LZajmi/STM32F4-dev-board/README.md

## Project Overview
render
render2
