LZajmi/STM32F4-dev-board/KiCad Libraries/141972109-21-usb4145-03-0170-c/usb4145-03-0170-c.stl

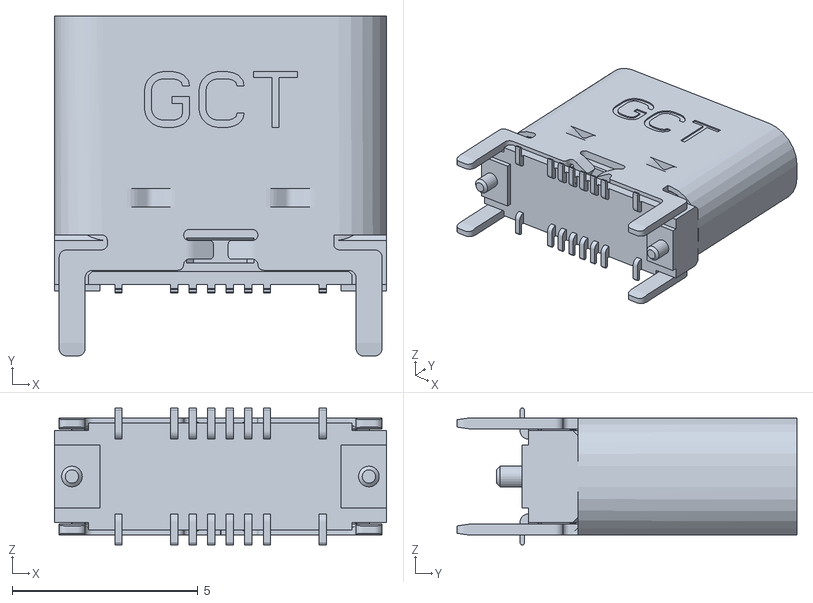
[picture p1: CAD file, 2025-03-24]
KiCad Libraries/141972109-21-usb4145-03-0170-c/usb4145-03-0170-c.stl
8.95 x 9.16 x 3.69
