LZajmi/STM32F4-dev-board/KiCad Libraries/1N4148W-TP/1N4148W-TP.step

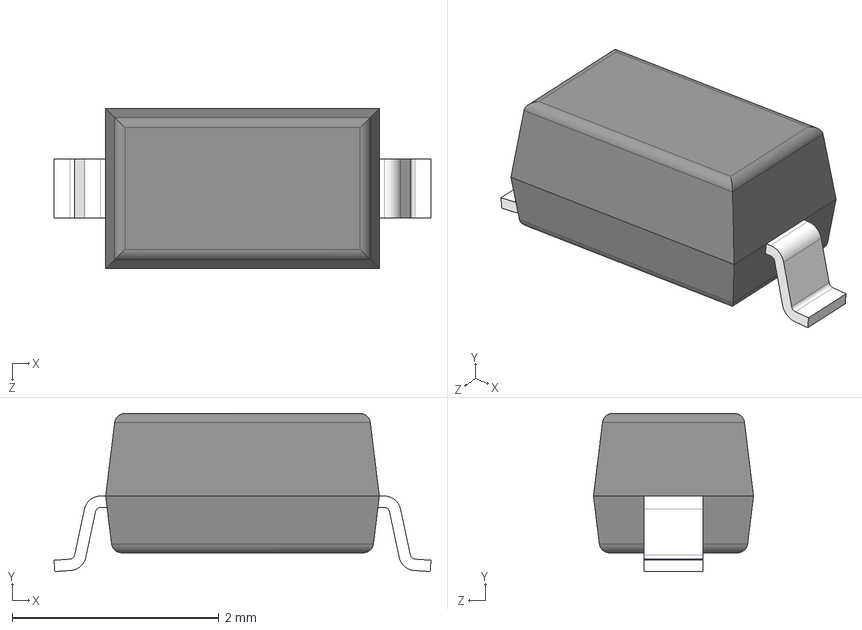
[picture p2: CAD file, 2025-03-24]
KiCad Libraries/1N4148W-TP/1N4148W-TP.step
3.65 x 1.53 x 1.55 mm
