LZajmi/STM32F4-dev-board/KiCad Libraries/3D model/L834-1G1T-S7--3DModel-STEP-56544.STEP

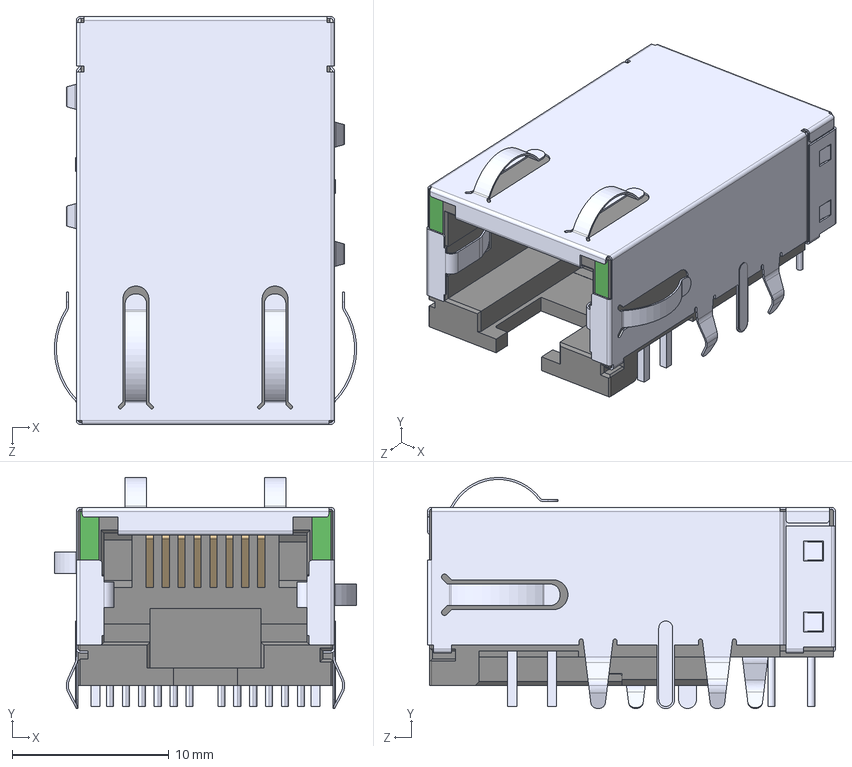
[picture p3: CAD file, 2025-03-24]
KiCad Libraries/3D model/L834-1G1T-S7--3DModel-STEP-56544.STEP
19.3 x 14.8 x 26.1 mm
