LZajmi/STM32F4-dev-board/KiCad Libraries/93C46/93C46.step

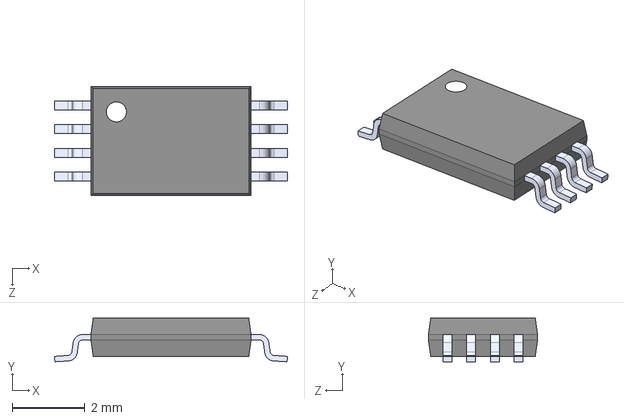
[picture p4: CAD file, 2025-03-24]
KiCad Libraries/93C46/93C46.step
6.40 x 1.20 x 3.00 mm
