LZajmi/STM32F4-dev-board/KiCad Libraries/93C46C-I_P/93C46C-I_P.step

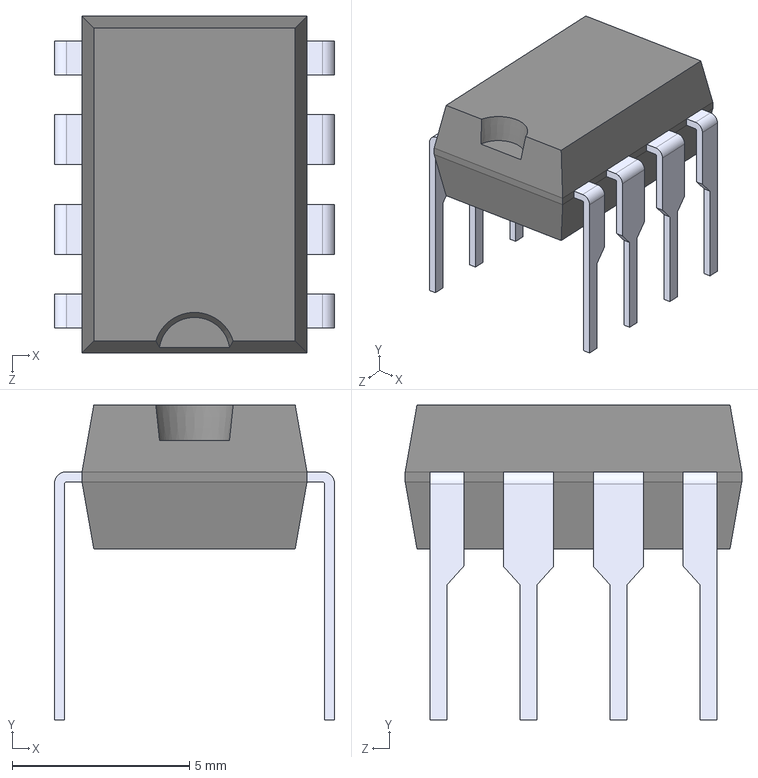
[picture p5: CAD file, 2025-03-24]
KiCad Libraries/93C46C-I_P/93C46C-I_P.step
7.91 x 8.89 x 9.50 mm
