LZajmi/STM32F4-dev-board/KiCad Libraries/ABM8-24.000MHZ-B2-T/ABM8-24.000MHZ-B2-T.step

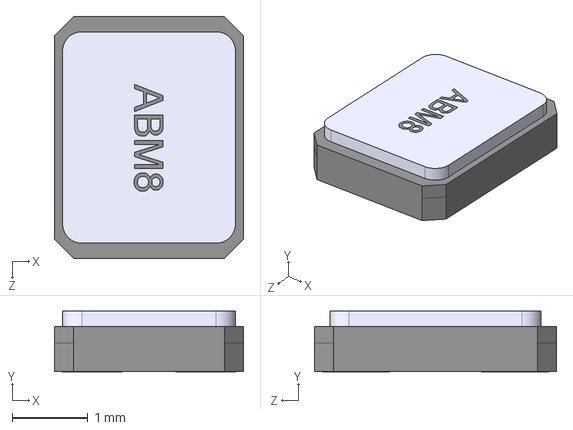
[picture p6: CAD file, 2025-03-24]
KiCad Libraries/ABM8-24.000MHZ-B2-T/ABM8-24.000MHZ-B2-T.step
2.50 x 0.8 x 3.20 mm
