LZajmi/STM32F4-dev-board/KiCad Libraries/ABM8G-12.000MHZ-18-D2Y-T/ABM8G-12.000MHZ-18-D2Y-T.step

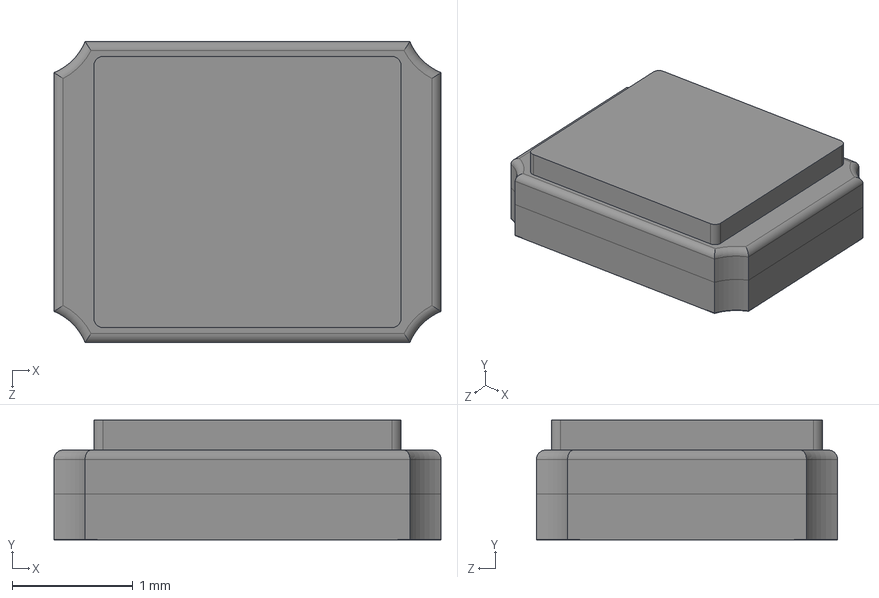
[picture p7: CAD file, 2025-03-24]
KiCad Libraries/ABM8G-12.000MHZ-18-D2Y-T/ABM8G-12.000MHZ-18-D2Y-T.step
3.20 x 0.991 x 2.49 mm
