LZajmi/STM32F4-dev-board/KiCad Libraries/AltiumDesigner-Libraries-main/LQFP48-7x7mm.step

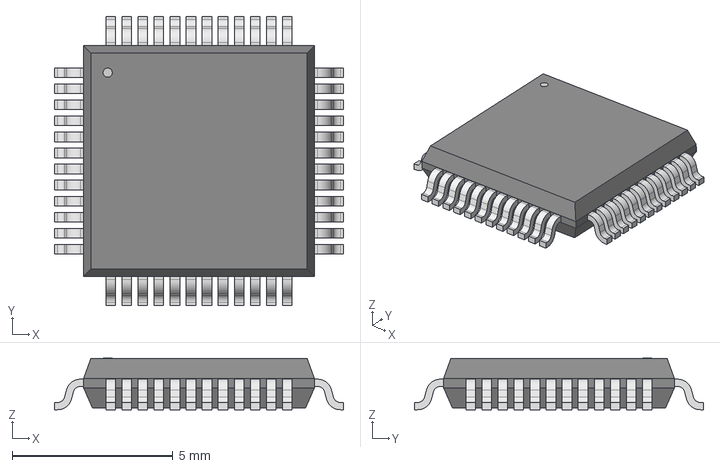
[picture p8: CAD file, 2025-03-24]
KiCad Libraries/AltiumDesigner-Libraries-main/LQFP48-7x7mm.step
8.99 x 8.99 x 1.60 mm
