LZajmi/STM32F4-dev-board/KiCad Libraries/B3AL_1003P/b3al-1003p.stp

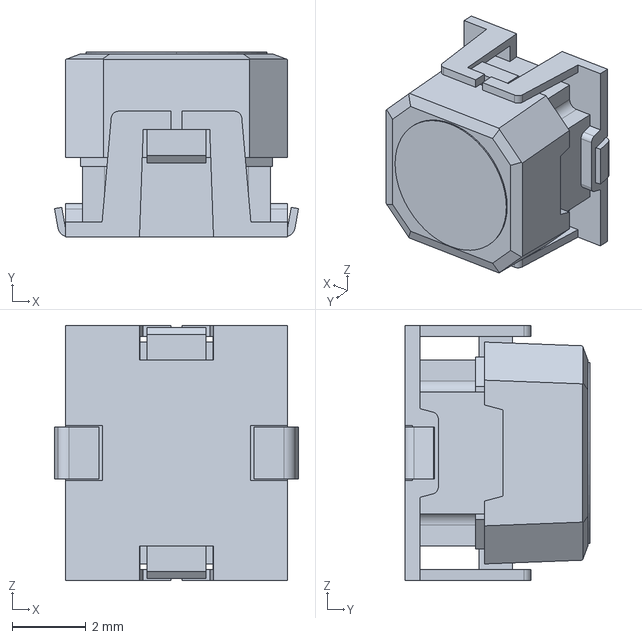
[picture p9: CAD file, 2025-03-24]
KiCad Libraries/B3AL_1003P/b3al-1003p.stp
6.60 x 5.00 x 6.90 mm
