LZajmi/STM32F4-dev-board/KiCad Libraries/BLM15AG601SN1D/BLM15AG601SN1D.step

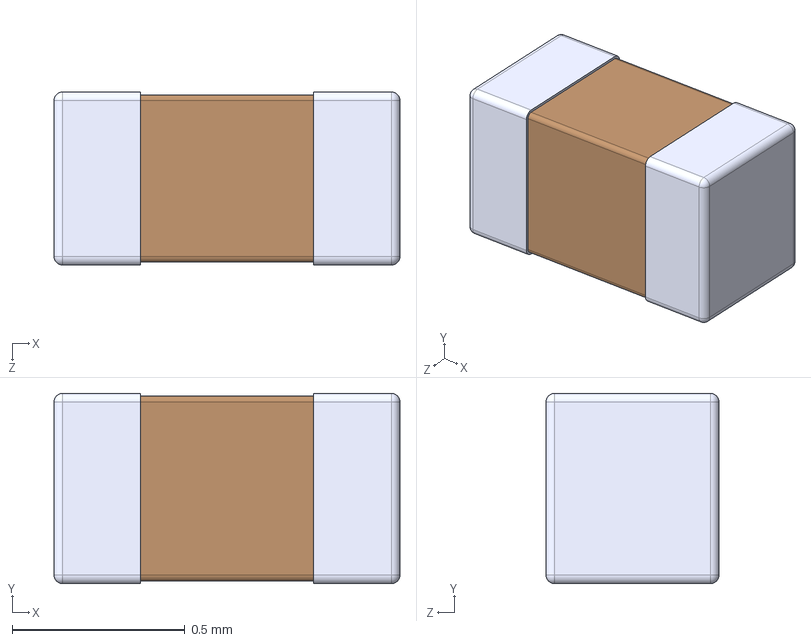
[picture p10: CAD file, 2025-03-24]
KiCad Libraries/BLM15AG601SN1D/BLM15AG601SN1D.step
1.00 x 0.55 x 0.5 mm
