LZajmi/STM32F4-dev-board/KiCad Libraries/BMI270/BMI270.step

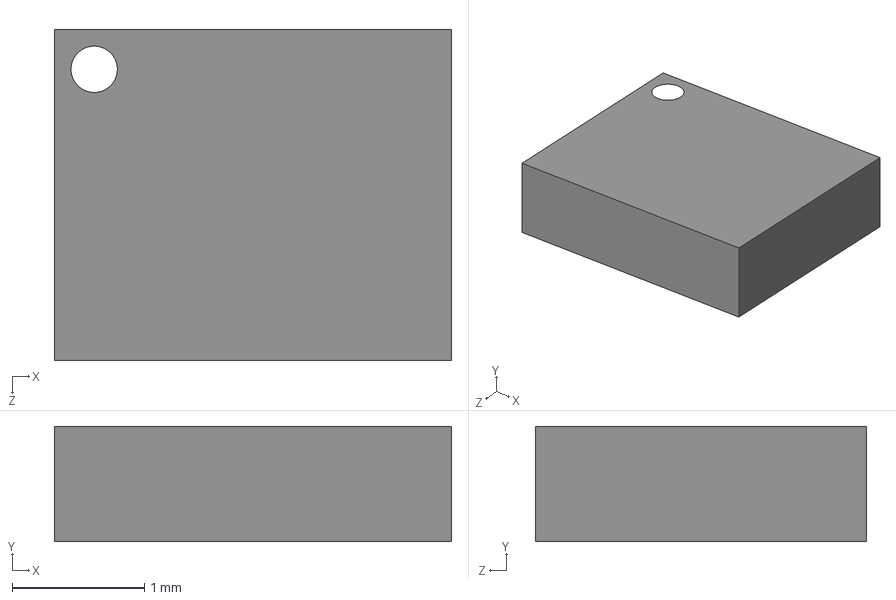
[picture p11: CAD file, 2025-03-24]
KiCad Libraries/BMI270/BMI270.step
3.00 x 0.87 x 2.50 mm
