LZajmi/STM32F4-dev-board/KiCad Libraries/CC0201MRX5R6BB105/AltiumDesigner/CAP_CC0201_YAG.step

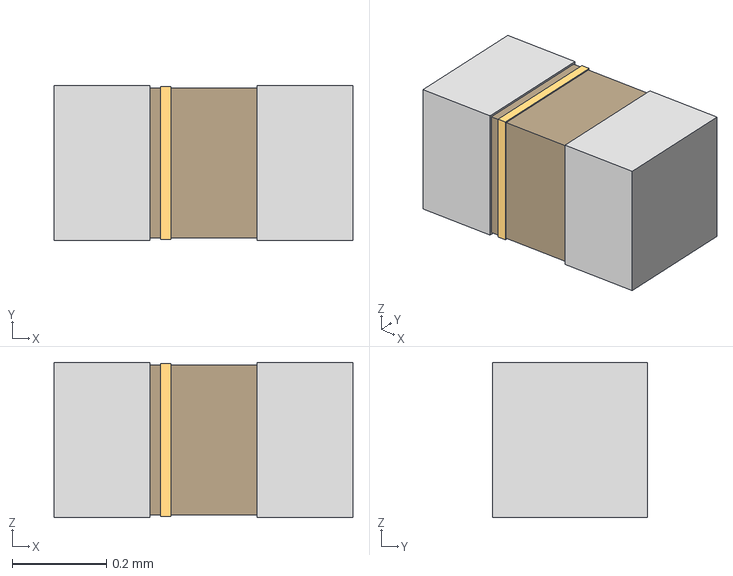
[picture p12: CAD file, 2025-03-24]
KiCad Libraries/CC0201MRX5R6BB105/AltiumDesigner/CAP_CC0201_YAG.step
0.636 x 0.33 x 0.33 mm
