LZajmi/STM32F4-dev-board/KiCad Libraries/CC0402MRX5R6BB106/AltiumDesigner/CAP_CC0402_YAG.step

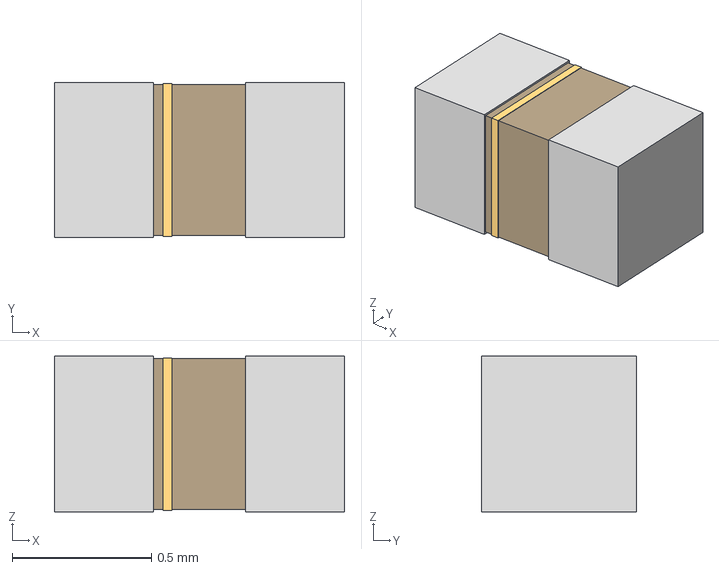
[picture p13: CAD file, 2025-03-24]
KiCad Libraries/CC0402MRX5R6BB106/AltiumDesigner/CAP_CC0402_YAG.step
1.04 x 0.558 x 0.559 mm
