LZajmi/STM32F4-dev-board/KiCad Libraries/CR0402-FX-1002GLF/CR0402-FX-1002GLF.step

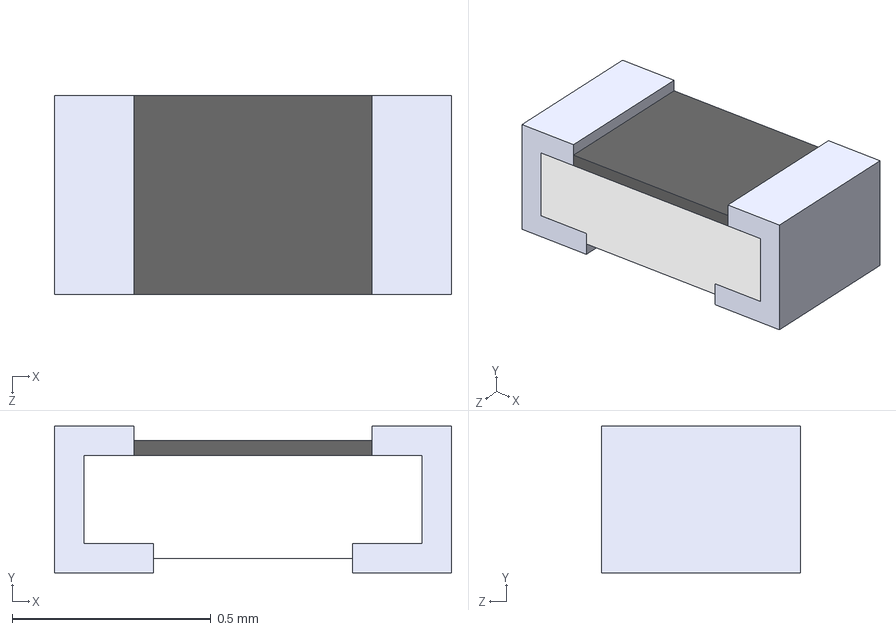
[picture p14: CAD file, 2025-03-24]
KiCad Libraries/CR0402-FX-1002GLF/CR0402-FX-1002GLF.step
1.00 x 0.37 x 0.5 mm
