LZajmi/STM32F4-dev-board/KiCad Libraries/CRCW0402220RFKEDC/CRCW0402220RFKEDC/3D/CRCW0402220RFKEDC.stp

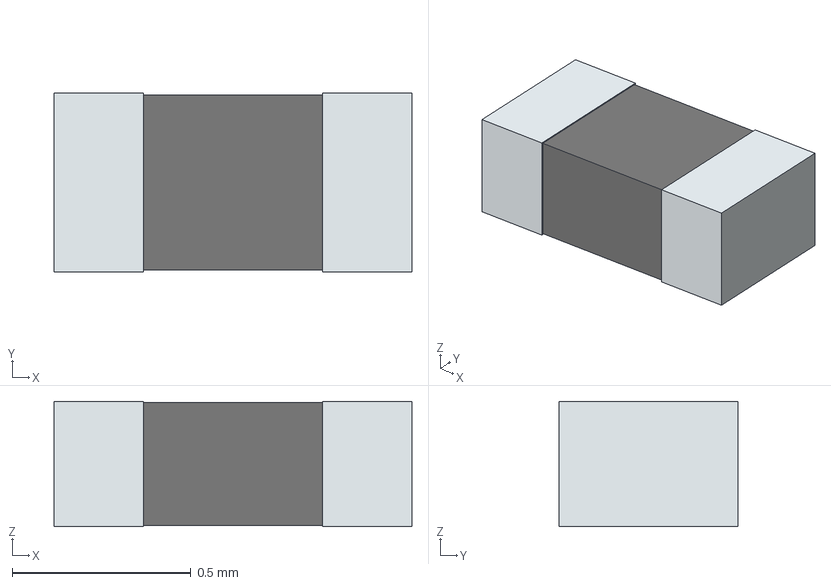
[picture p15: CAD file, 2025-03-24]
KiCad Libraries/CRCW0402220RFKEDC/CRCW0402220RFKEDC/3D/CRCW0402220RFKEDC.stp
1.00 x 0.5 x 0.35 mm
term1
term2
