LZajmi/STM32F4-dev-board/KiCad Libraries/CRCW040266K5FKEDC/CRCW040266K5FKEDC.step

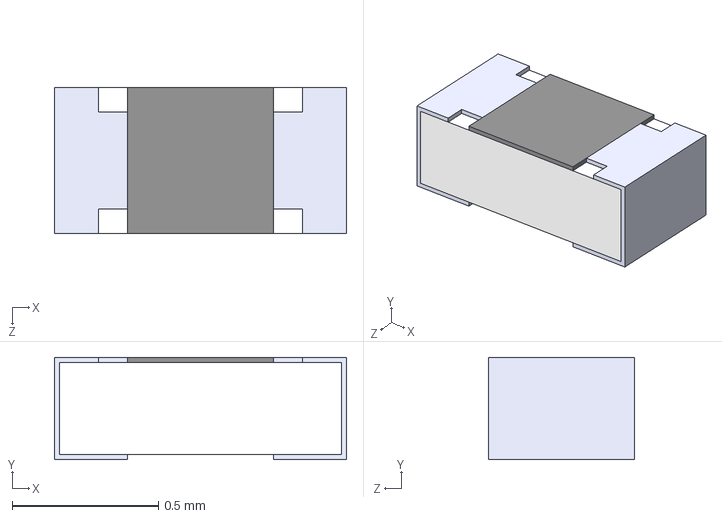
[picture p16: CAD file, 2025-03-24]
KiCad Libraries/CRCW040266K5FKEDC/CRCW040266K5FKEDC.step
1 x 0.35 x 0.5 mm
