LZajmi/STM32F4-dev-board/KiCad Libraries/DC-005/DC-005.step

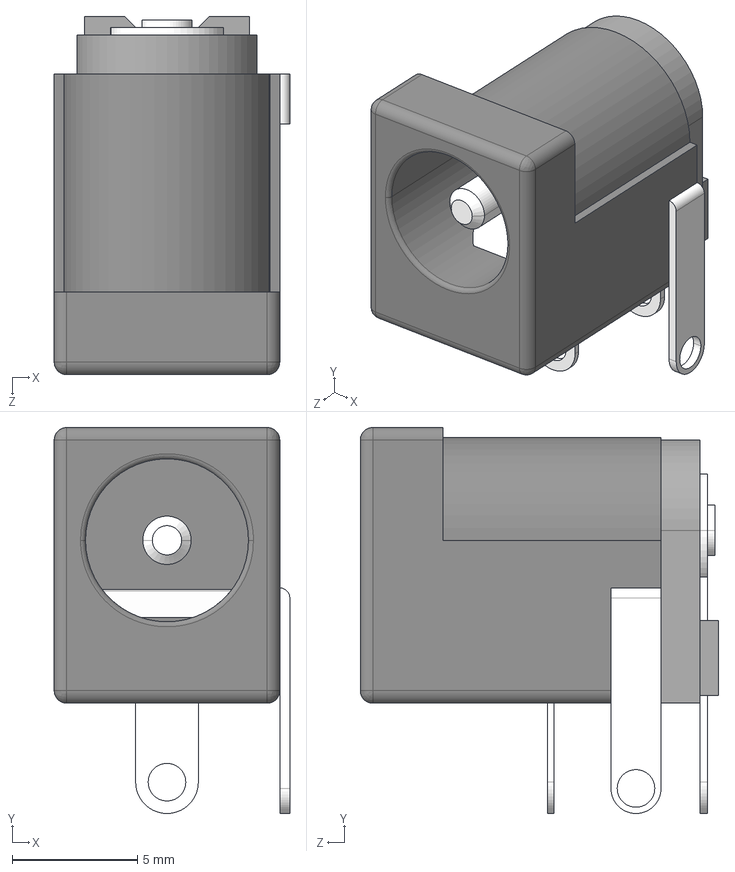
[picture p17: CAD file, 2025-03-24]
KiCad Libraries/DC-005/DC-005.step
9.40 x 15.4 x 14.3 mm
