LZajmi/STM32F4-dev-board/KiCad Libraries/DCJ200-10-A-XX-K_REVA/DCJ200-10-A-XX-K_REVA.step

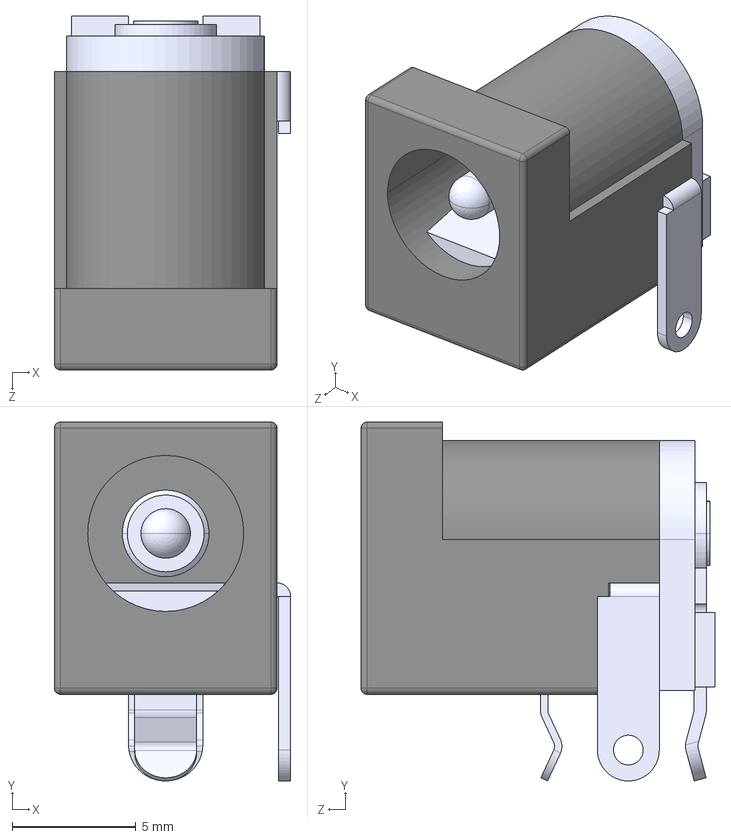
[picture p18: CAD file, 2025-03-24]
KiCad Libraries/DCJ200-10-A-XX-K_REVA/DCJ200-10-A-XX-K_REVA.step
9.55 x 14.5 x 14.3 mm
