LZajmi/STM32F4-dev-board/KiCad Libraries/ECS-2520MV-130-BN-TR/ECS-2520MV-130-BN-TR/3D/ECS-2520MV-130-BN-TR.stp

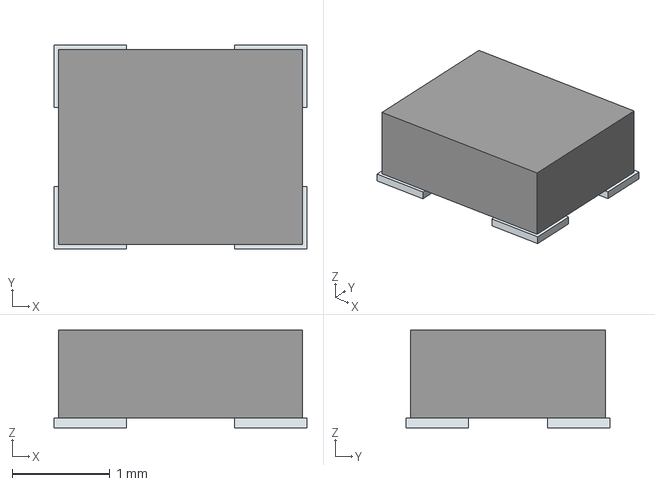
[picture p19: CAD file, 2025-03-24]
KiCad Libraries/ECS-2520MV-130-BN-TR/ECS-2520MV-130-BN-TR/3D/ECS-2520MV-130-BN-TR.stp
2.59 x 2.09 x 1.00 mm
Pins
