LZajmi/STM32F4-dev-board/KiCad Libraries/ECS-2520MV-480-BN-TR/ECS-2520MV-480-BN-TR.step

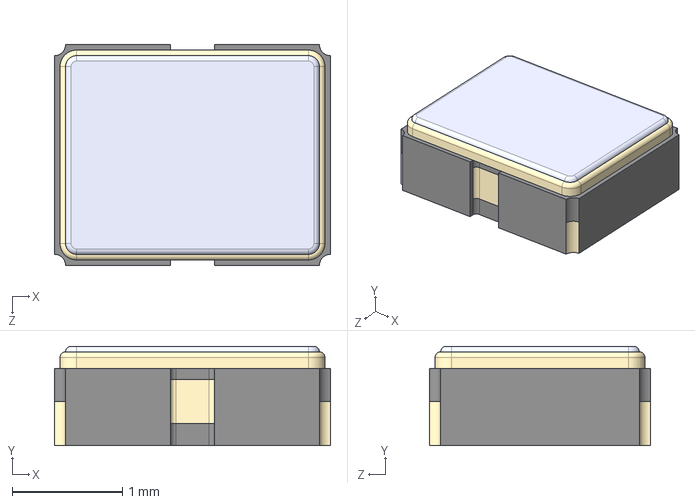
[picture p20: CAD file, 2025-03-24]
KiCad Libraries/ECS-2520MV-480-BN-TR/ECS-2520MV-480-BN-TR.step
2.50 x 0.9 x 2.00 mm
