LZajmi/STM32F4-dev-board/KiCad Libraries/ERJ3EKF4533V/ERJ3EKF4533V.step

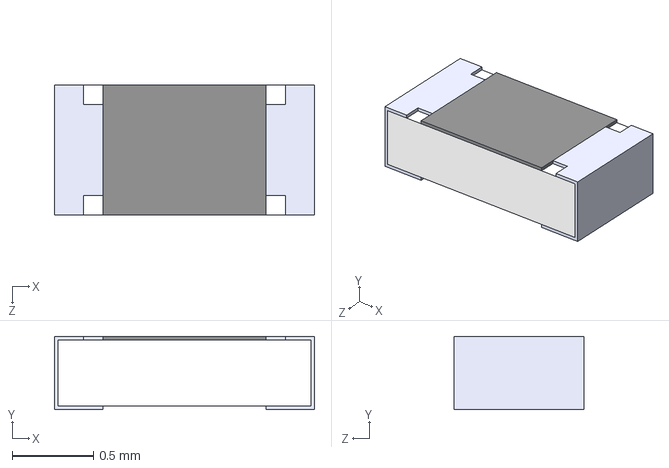
[picture p21: CAD file, 2025-03-24]
KiCad Libraries/ERJ3EKF4533V/ERJ3EKF4533V.step
1.60 x 0.45 x 0.8 mm
