LZajmi/STM32F4-dev-board/KiCad Libraries/FT4232H_56Q_TRAY/FT4232H-56Q-TRAY.step

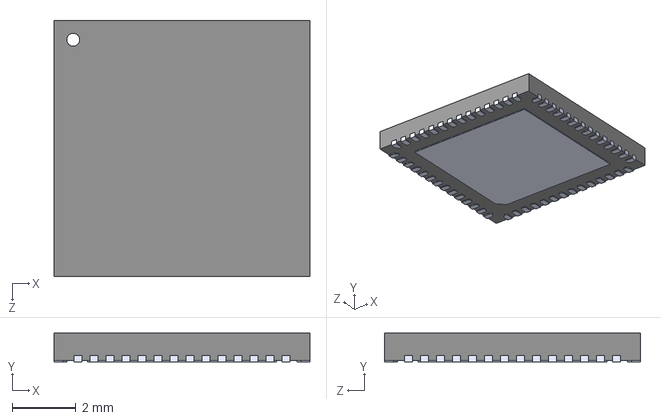
[picture p22: CAD file, 2025-03-24]
KiCad Libraries/FT4232H_56Q_TRAY/FT4232H-56Q-TRAY.step
8.00 x 0.9 x 8.00 mm
