LZajmi/STM32F4-dev-board/KiCad Libraries/FW-10-04-G-D-100-065/FW-10-04-G-D-100-065.step

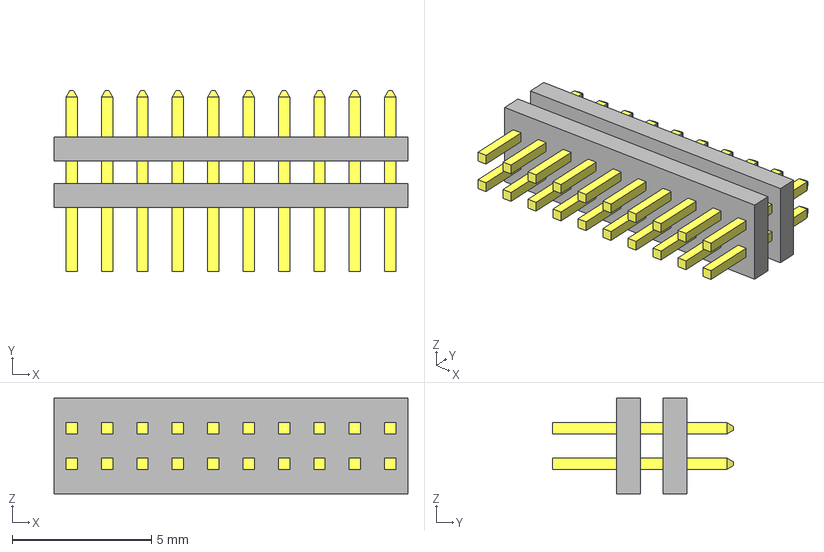
[picture p23: CAD file, 2025-03-24]
KiCad Libraries/FW-10-04-G-D-100-065/FW-10-04-G-D-100-065.step
12.7 x 6.48 x 3.43 mm
FW-10-04-G-D-100-065_bottom_body
FW-10-04-G-D-100-065_pins1
FW-10-04-G-D-100-100_pins2
FW-10-04-G-D-100-065_top_body
