LZajmi/STM32F4-dev-board/KiCad Libraries/GRM21BR71A475KE51L/GRM21BR71A475KE51L.step

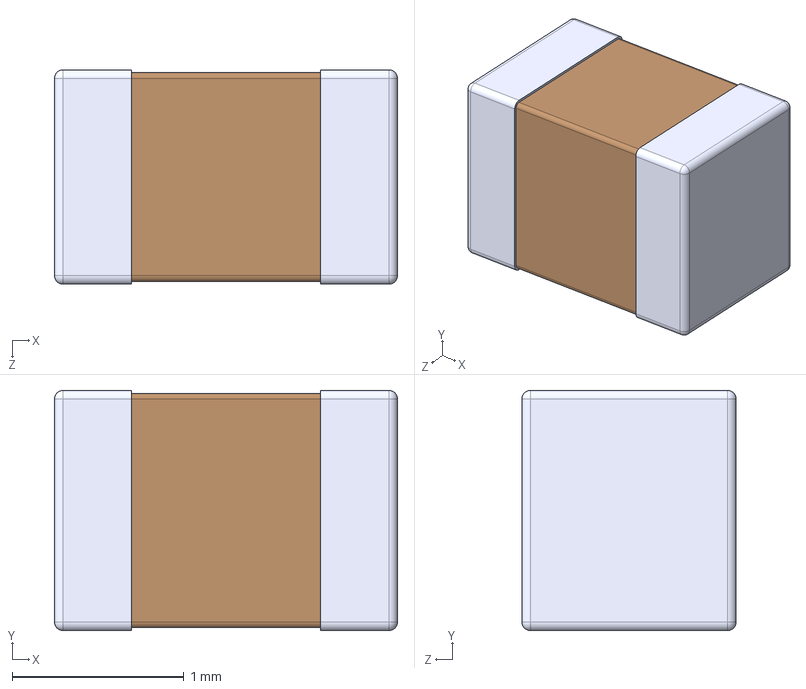
[picture p24: CAD file, 2025-03-24]
KiCad Libraries/GRM21BR71A475KE51L/GRM21BR71A475KE51L.step
2.00 x 1.40 x 1.25 mm
