LZajmi/STM32F4-dev-board/KiCad Libraries/HSMW_C191/HSMW-C191.step

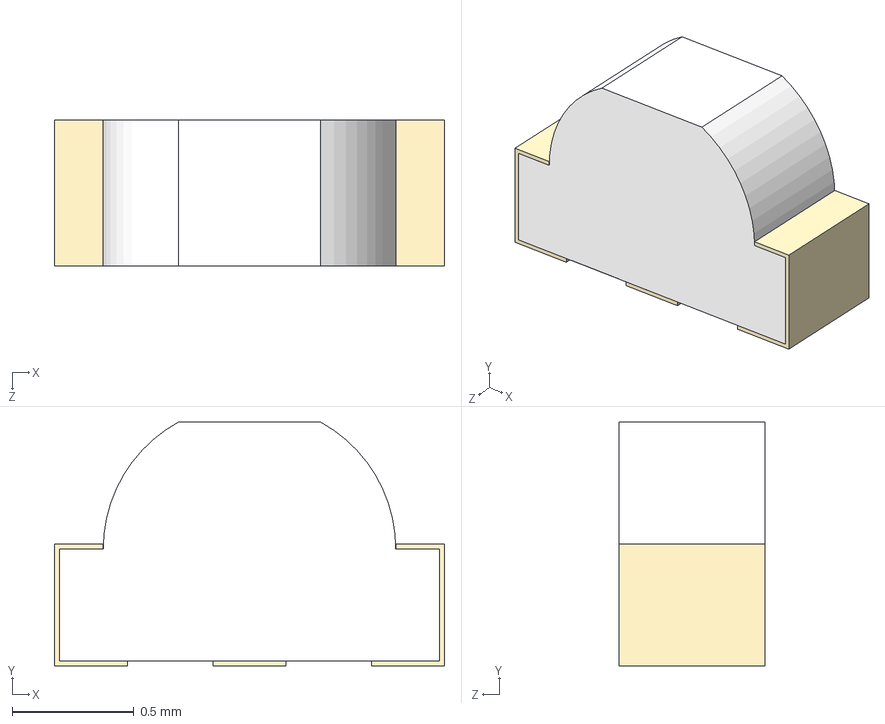
[picture p25: CAD file, 2025-03-24]
KiCad Libraries/HSMW_C191/HSMW-C191.step
1.60 x 1.00 x 0.6 mm
