LZajmi/STM32F4-dev-board/KiCad Libraries/KSZ9031RNXCA/KSZ9031RNXCA.step

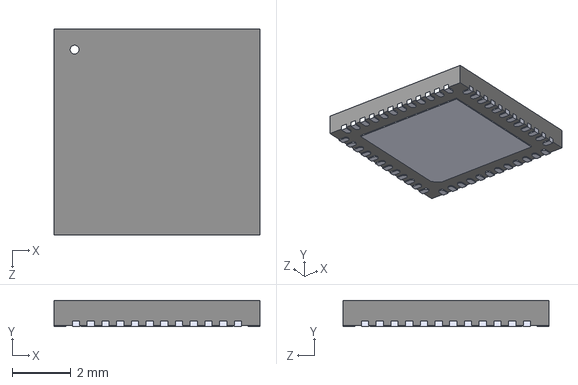
[picture p26: CAD file, 2025-03-24]
KiCad Libraries/KSZ9031RNXCA/KSZ9031RNXCA.step
7.00 x 0.9 x 7.00 mm
