LZajmi/STM32F4-dev-board/KiCad Libraries/LIB_MT25QL512ABB8ESF-0AAT/MT25QL512ABB8ESF-0AAT/3D/MT25QL512ABB8ESF-0AAT.stp

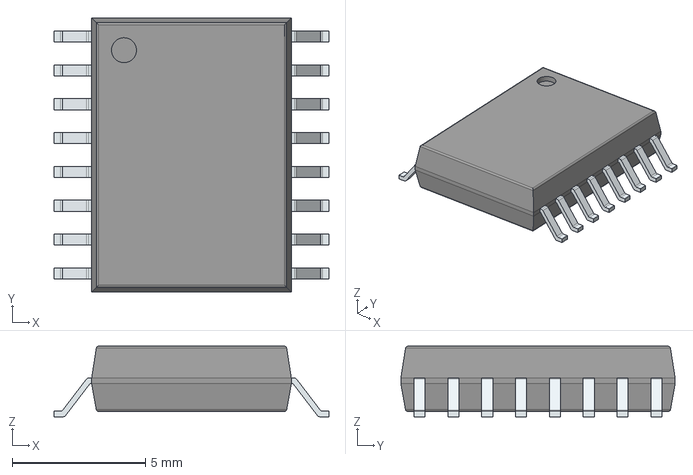
[picture p27: CAD file, 2025-03-24]
KiCad Libraries/LIB_MT25QL512ABB8ESF-0AAT/MT25QL512ABB8ESF-0AAT/3D/MT25QL512ABB8ESF-0AAT.stp
10.3 x 10.3 x 2.65 mm
PinsArrayLR
