LZajmi/STM32F4-dev-board/KiCad Libraries/LIB_PCM12SMTR/PCM12SMTR/3D/PCM12SMTR.stp

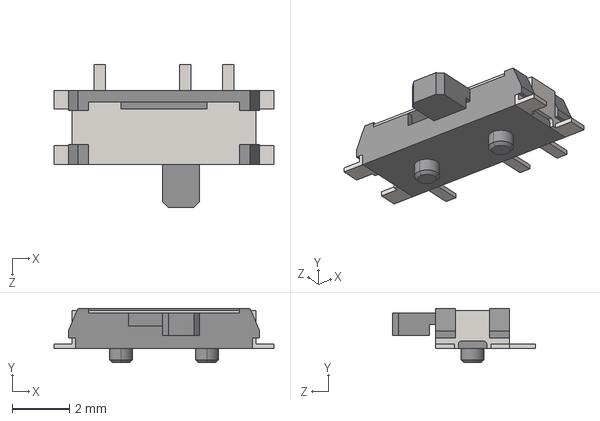
[picture p28: CAD file, 2025-03-24]
KiCad Libraries/LIB_PCM12SMTR/PCM12SMTR/3D/PCM12SMTR.stp
7.70 x 1.90 x 5.00 mm
