LZajmi/STM32F4-dev-board/KiCad Libraries/LIB_RN73R1ETTP50R0F50/RN73R1ETTP50R0F50/3D/RN73R1ETTP50R0F50.stp

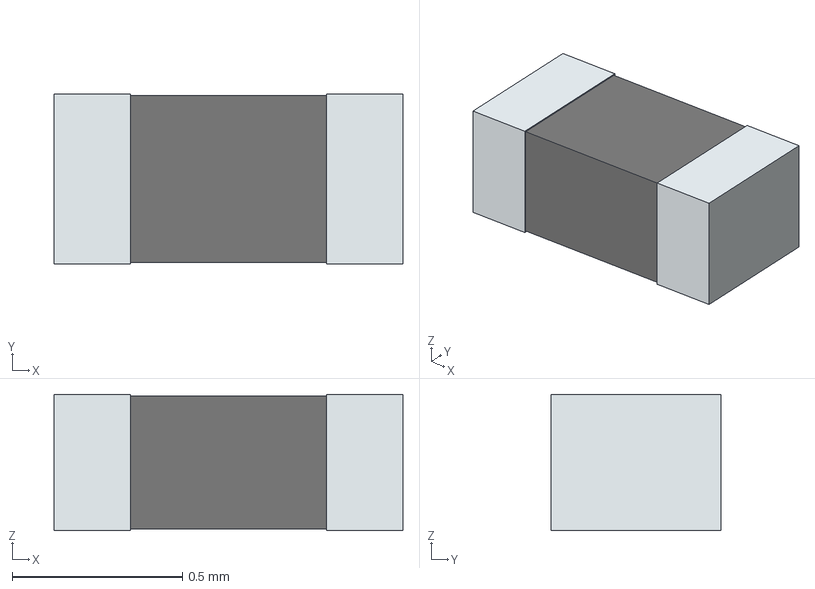
[picture p29: CAD file, 2025-03-24]
KiCad Libraries/LIB_RN73R1ETTP50R0F50/RN73R1ETTP50R0F50/3D/RN73R1ETTP50R0F50.stp
1.02 x 0.5 x 0.4 mm
term1
term2
