LZajmi/STM32F4-dev-board/KiCad Libraries/LIB_SN74LV1T125DCKRG4/SN74LV1T125DCKRG4/3D/SN74LV1T125DCKRG4.stp

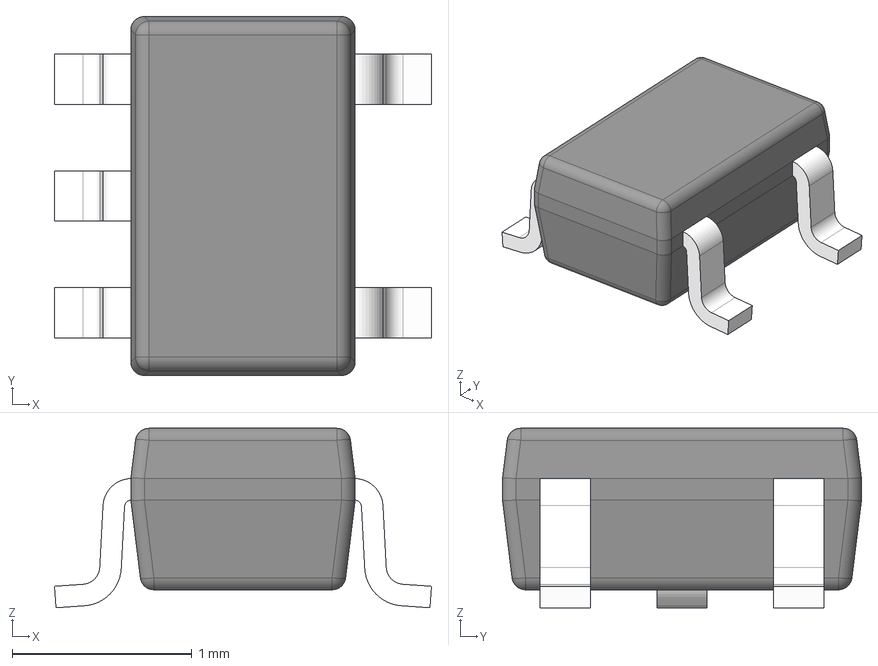
[picture p30: CAD file, 2025-03-24]
KiCad Libraries/LIB_SN74LV1T125DCKRG4/SN74LV1T125DCKRG4/3D/SN74LV1T125DCKRG4.stp
2.10 x 2.00 x 1.00 mm
BODY-SOT
LEAD-SOT x 5
PIN1-ID
