LZajmi/STM32F4-dev-board/KiCad Libraries/LIB_TPD2E009DBZR/TPD2E009DBZR/3D/TPD2E009DBZR.stp

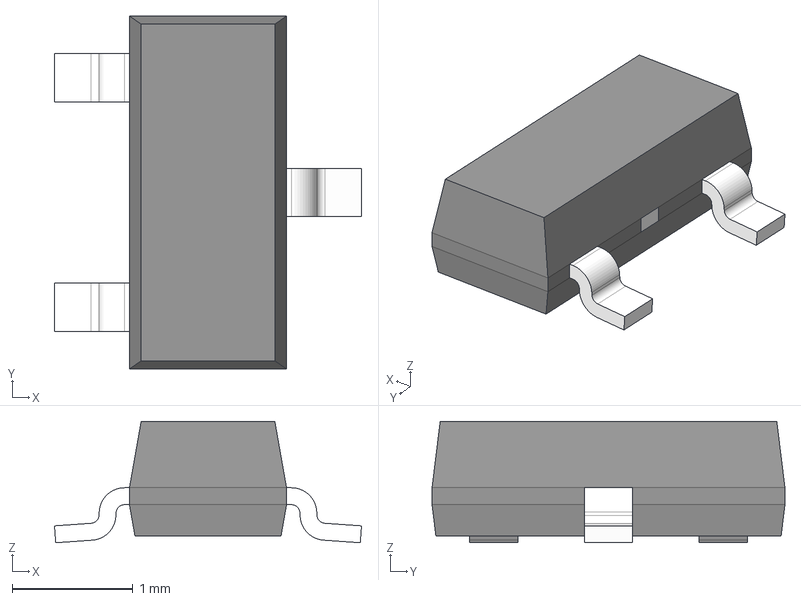
[picture p31: CAD file, 2025-03-24]
KiCad Libraries/LIB_TPD2E009DBZR/TPD2E009DBZR/3D/TPD2E009DBZR.stp
2.54 x 2.92 x 1.01 mm
BODY-SOT
LEAD-SOT x 3
PIN1-ID
TIEBAR
