LZajmi/STM32F4-dev-board/KiCad Libraries/LIB_XFL4015-471MEC/XFL4015-471MEC/3D/XFL4015-471MEC.stp

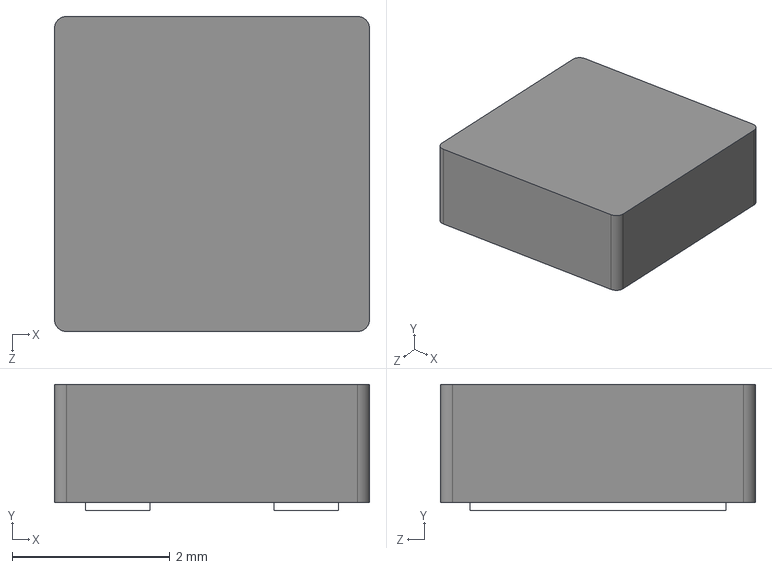
[picture p32: CAD file, 2025-03-24]
KiCad Libraries/LIB_XFL4015-471MEC/XFL4015-471MEC/3D/XFL4015-471MEC.stp
4.00 x 1.60 x 4.00 mm
