LZajmi/STM32F4-dev-board/KiCad Libraries/LIS3DH/LIS3DH.step

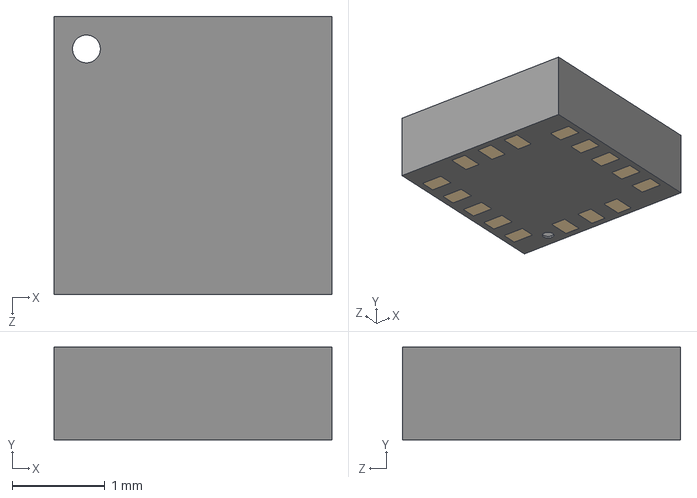
[picture p33: CAD file, 2025-03-24]
KiCad Libraries/LIS3DH/LIS3DH.step
3.00 x 1.00 x 3.00 mm
