LZajmi/STM32F4-dev-board/KiCad Libraries/MPU-6050/MPU-6050.step

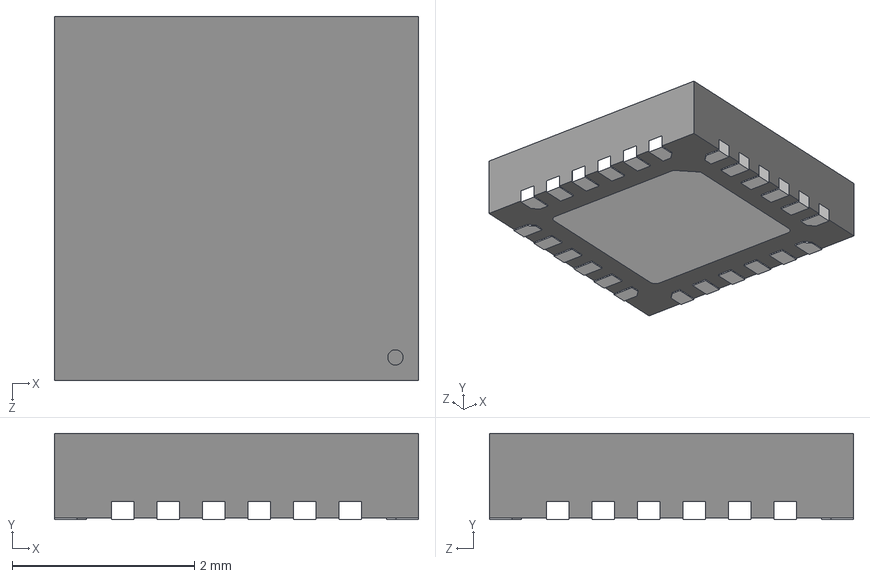
[picture p34: CAD file, 2025-03-24]
KiCad Libraries/MPU-6050/MPU-6050.step
4.00 x 0.95 x 4.00 mm
