LZajmi/STM32F4-dev-board/KiCad Libraries/MT25QL512ABB8ESF-0AAT/MT25QL512ABB8ESF-0AAT.step

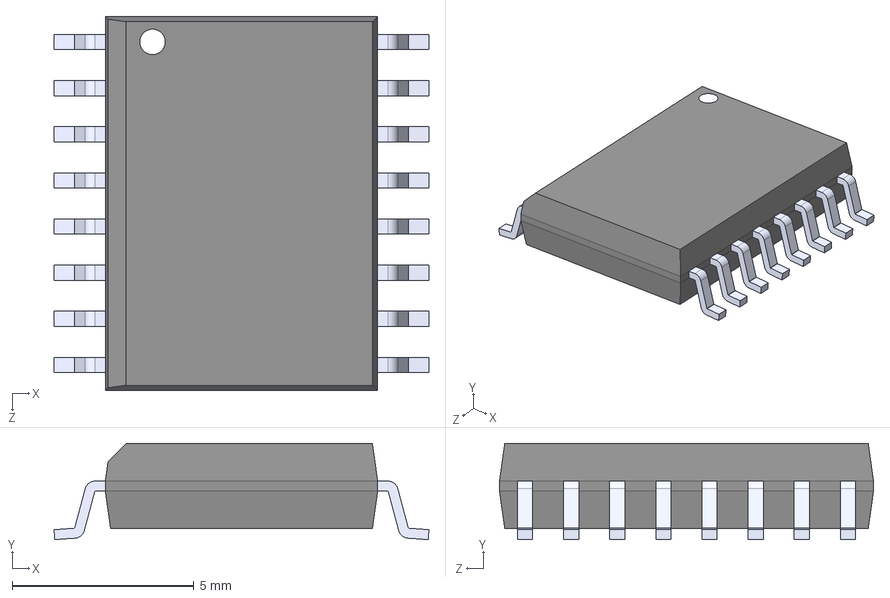
[picture p35: CAD file, 2025-03-24]
KiCad Libraries/MT25QL512ABB8ESF-0AAT/MT25QL512ABB8ESF-0AAT.step
10.3 x 2.65 x 10.3 mm
