LZajmi/STM32F4-dev-board/KiCad Libraries/PARTserver22024110721085440054269d0b6156e/TSW-120-24-T-S.stp

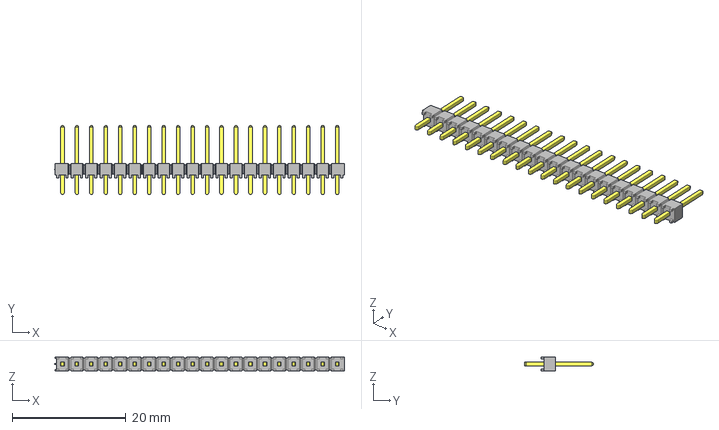
[picture p36: CAD file, 2025-03-24]
KiCad Libraries/PARTserver22024110721085440054269d0b6156e/TSW-120-24-T-S.stp
50.9 x 12.2 x 2.54 mm
TSW-120-24-T-S_body
T-1S6-17-TSW-1-24-20-S
