LZajmi/STM32F4-dev-board/KiCad Libraries/RC0402FR-07100RL/RC0402FR-07100RL.step

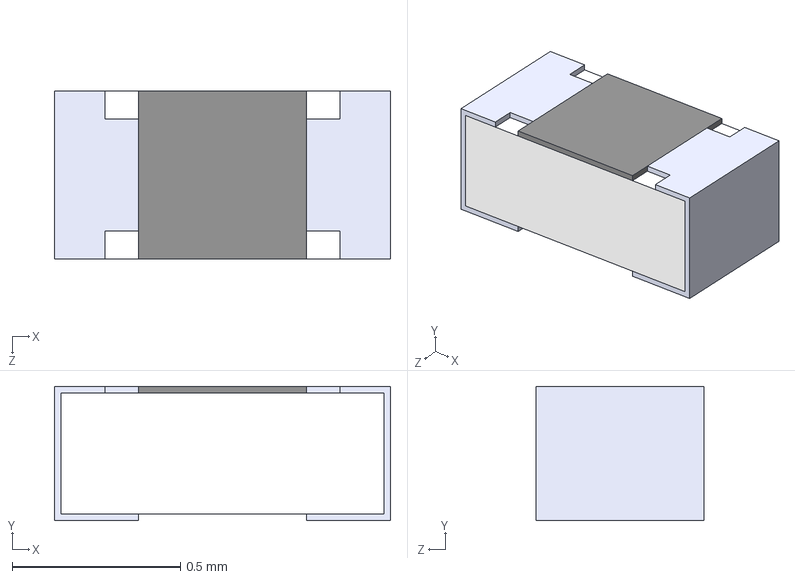
[picture p37: CAD file, 2025-03-24]
KiCad Libraries/RC0402FR-07100RL/RC0402FR-07100RL.step
1 x 0.4 x 0.5 mm
