LZajmi/STM32F4-dev-board/KiCad Libraries/RC0603FR-07100KL/RC0603FR-07100KL.step

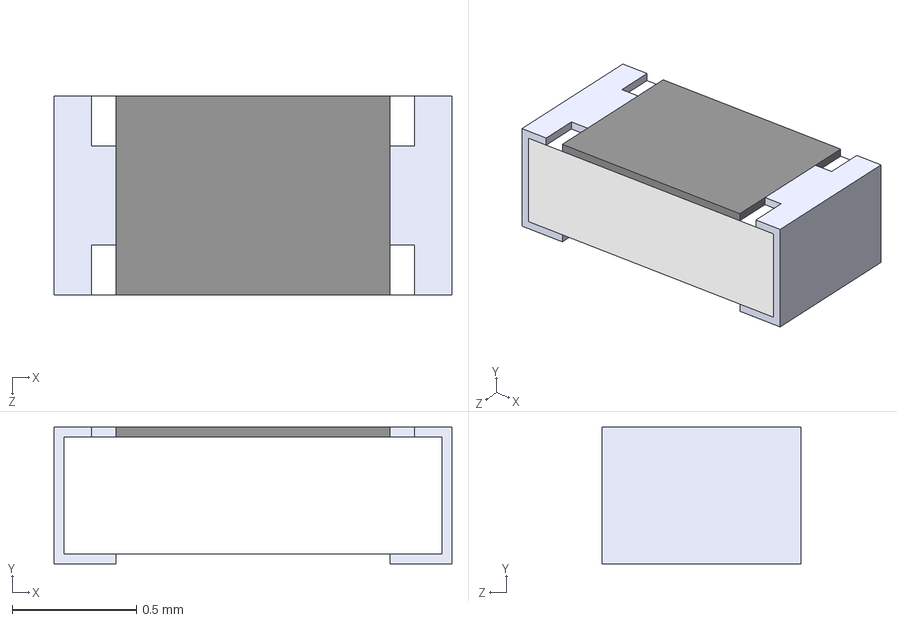
[picture p38: CAD file, 2025-03-24]
KiCad Libraries/RC0603FR-07100KL/RC0603FR-07100KL.step
1.60 x 0.55 x 0.8 mm
