LZajmi/STM32F4-dev-board/KiCad Libraries/RC0603FR-0710K2L/RC0603FR-0710K2L.step

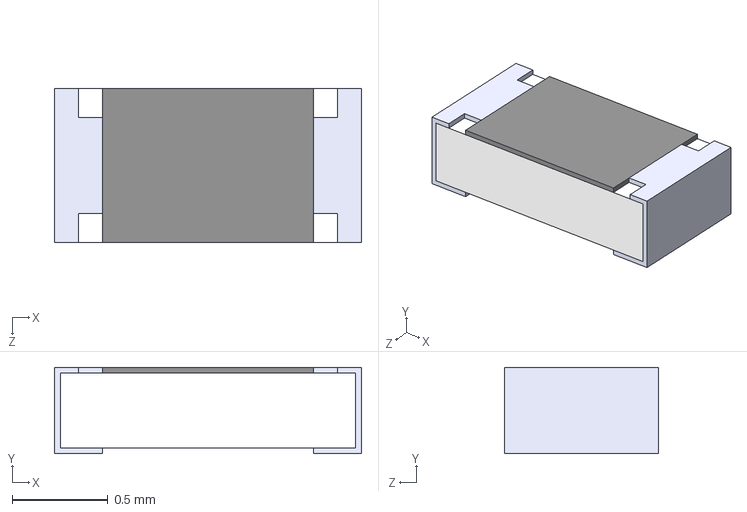
[picture p39: CAD file, 2025-03-24]
KiCad Libraries/RC0603FR-0710K2L/RC0603FR-0710K2L.step
1.60 x 0.45 x 0.8 mm
