LZajmi/STM32F4-dev-board/KiCad Libraries/RMCF0402FT27K0/RMCF0402FT27K0.step

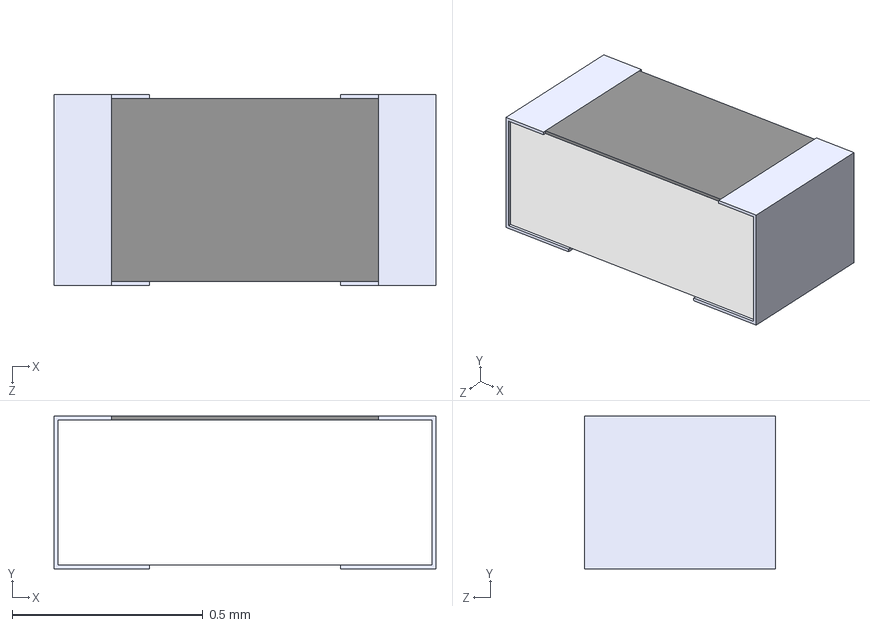
[picture p40: CAD file, 2025-03-24]
KiCad Libraries/RMCF0402FT27K0/RMCF0402FT27K0.step
1.00 x 0.4 x 0.5 mm
