LZajmi/STM32F4-dev-board/KiCad Libraries/SP3003_02XTG/AltiumDesigner/SOT553_LTF.step

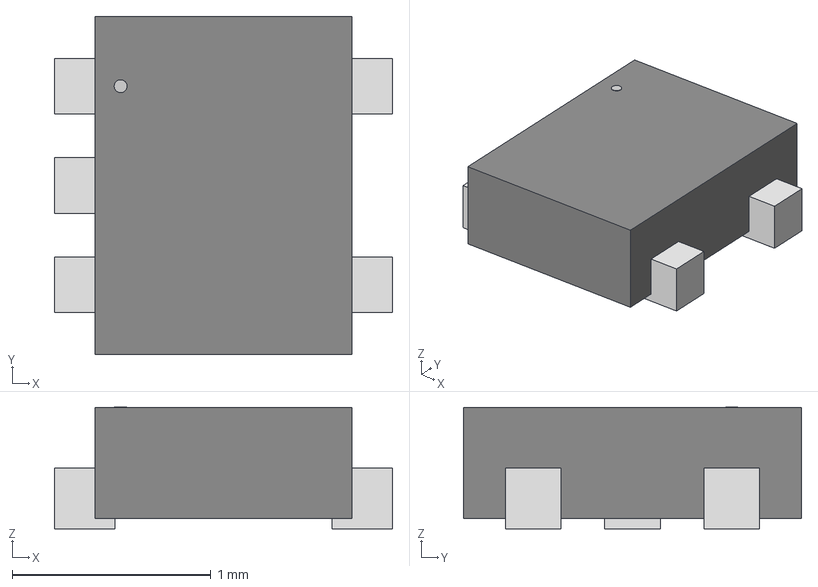
[picture p41: CAD file, 2025-03-24]
KiCad Libraries/SP3003_02XTG/AltiumDesigner/SOT553_LTF.step
1.70 x 1.70 x 0.612 mm
