LZajmi/STM32F4-dev-board/KiCad Libraries/SPM6530T-100M-HZ/SPM6530T-100M-HZ.step

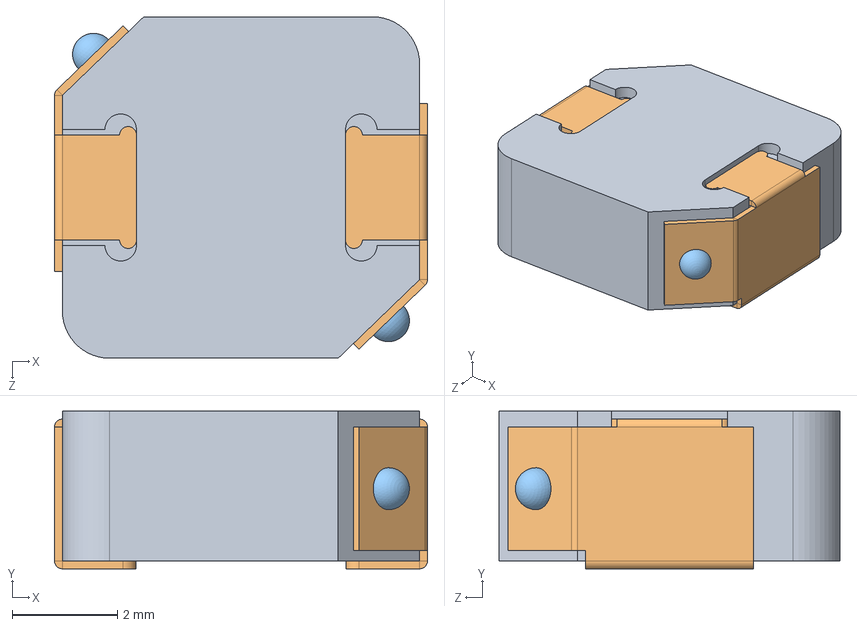
[picture p42: CAD file, 2025-03-24]
KiCad Libraries/SPM6530T-100M-HZ/SPM6530T-100M-HZ.step
7.10 x 3.00 x 6.50 mm
