LZajmi/STM32F4-dev-board/KiCad Libraries/STM32H750Vb/STM32H750VBT6.STEP

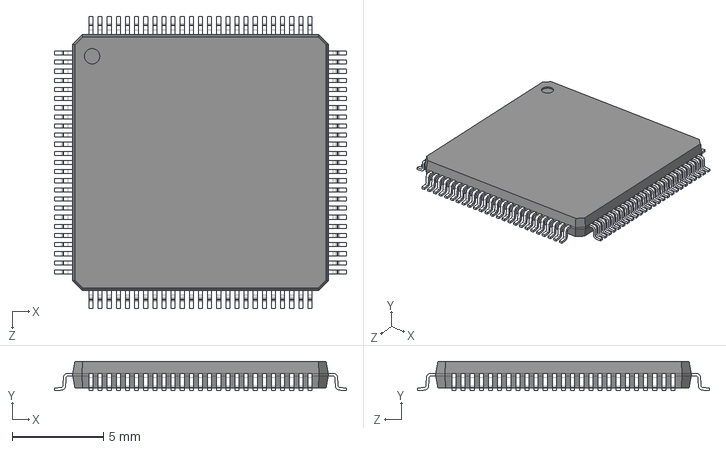
[picture p43: CAD file, 2025-03-24]
KiCad Libraries/STM32H750Vb/STM32H750VBT6.STEP
16.0 x 1.60 x 16.0 mm
