LZajmi/STM32F4-dev-board/KiCad Libraries/TPD2E009DRTR/TPD2E009DRTR.step

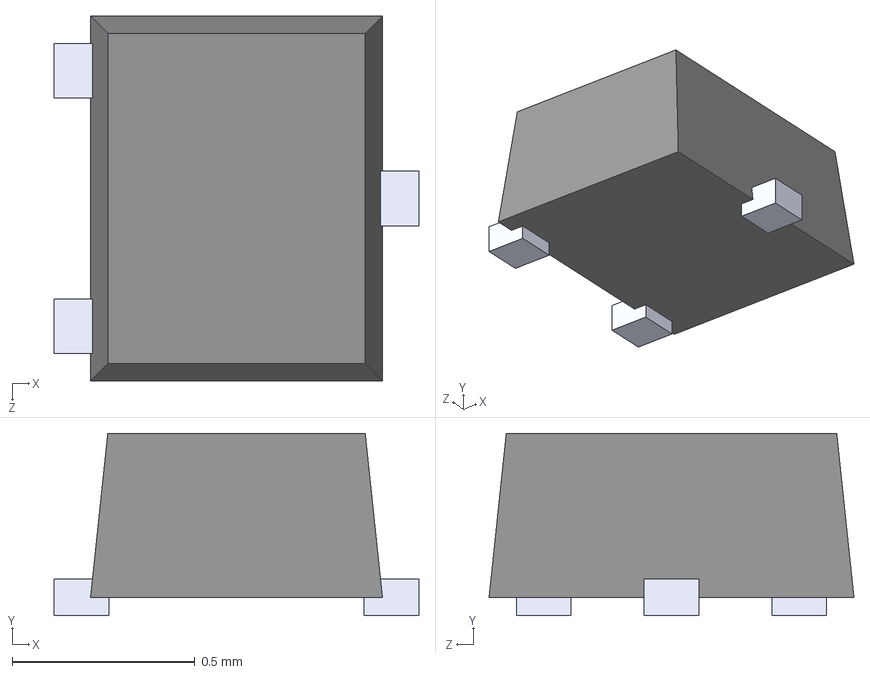
[picture p44: CAD file, 2025-03-24]
KiCad Libraries/TPD2E009DRTR/TPD2E009DRTR.step
1.00 x 0.5 x 1.00 mm
