LZajmi/STM32F4-dev-board/KiCad Libraries/TPD4E05U06DQAR/TPD4E05U06DQAR.step

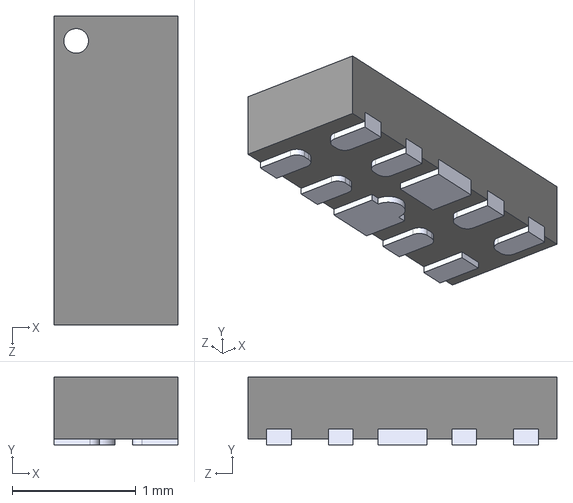
[picture p45: CAD file, 2025-03-24]
KiCad Libraries/TPD4E05U06DQAR/TPD4E05U06DQAR.step
1.00 x 0.55 x 2.50 mm
