LZajmi/STM32F4-dev-board/KiCad Libraries/TSX-3225/TSX-3225.step

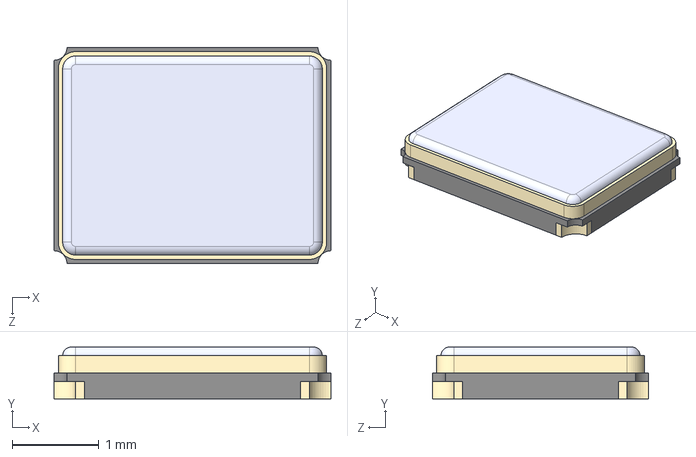
[picture p46: CAD file, 2025-03-24]
KiCad Libraries/TSX-3225/TSX-3225.step
3.20 x 0.6 x 2.50 mm
