LZajmi/STM32F4-dev-board/KiCad Libraries/USB3300-EZK-TR/USB3300-EZK-TR.step

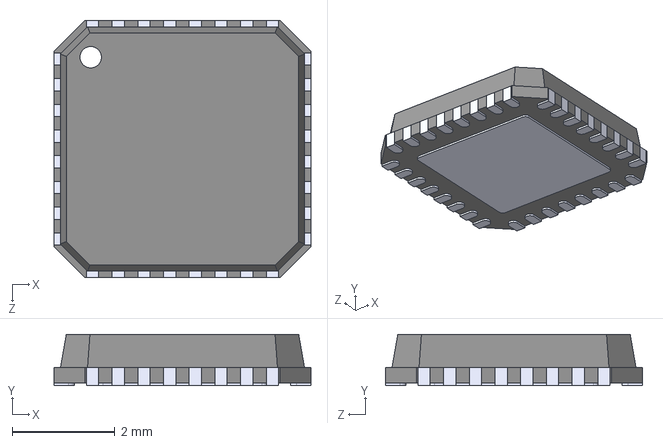
[picture p47: CAD file, 2025-03-24]
KiCad Libraries/USB3300-EZK-TR/USB3300-EZK-TR.step
5.00 x 1.00 x 5.00 mm
