LZajmi/STM32F4-dev-board/KiCad Libraries/USB4145-03-0070-C_REVA2/USB4145-03-0070-C_REVA2.step

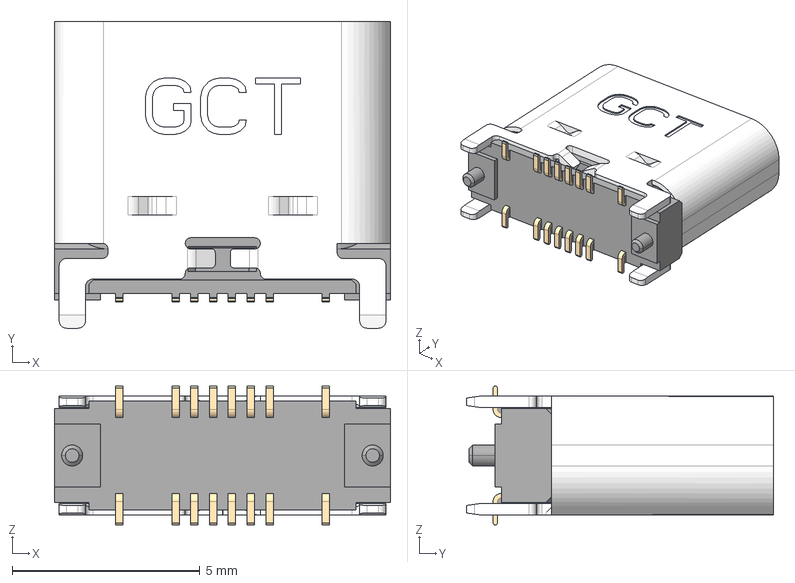
[picture p48: CAD file, 2025-03-24]
KiCad Libraries/USB4145-03-0070-C_REVA2/USB4145-03-0070-C_REVA2.step
8.95 x 8.16 x 3.69 mm
