LZajmi/STM32F4-dev-board/KiCad Libraries/W25Q32JVSSIQ/W25Q32JVSSIQ.step

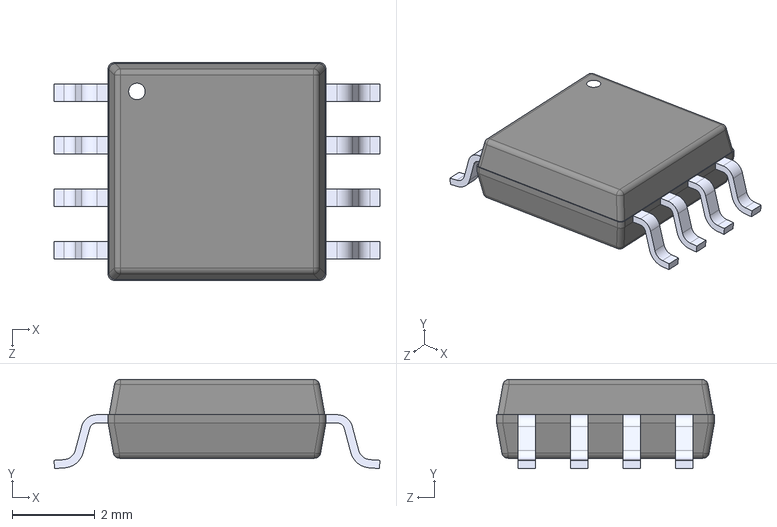
[picture p49: CAD file, 2025-03-24]
KiCad Libraries/W25Q32JVSSIQ/W25Q32JVSSIQ.step
7.90 x 2.16 x 5.28 mm
