LZajmi/STM32F4-dev-board/KiCad Libraries/XC7A100T-2FGG484C/XC7A100T-2FGG484C.step

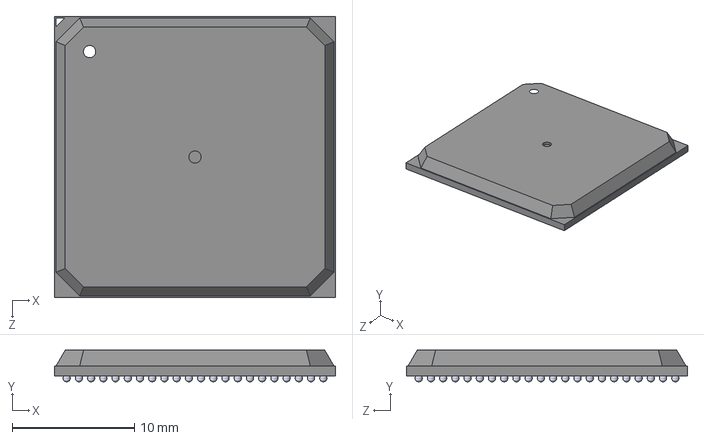
[picture p50: CAD file, 2025-03-24]
KiCad Libraries/XC7A100T-2FGG484C/XC7A100T-2FGG484C.step
23.0 x 2.60 x 23.0 mm
