LZajmi/STM32F4-dev-board/KiCad Libraries/SM04B-GHS-TB(LF)(SN)---3DModel-STEP-56544.STEP

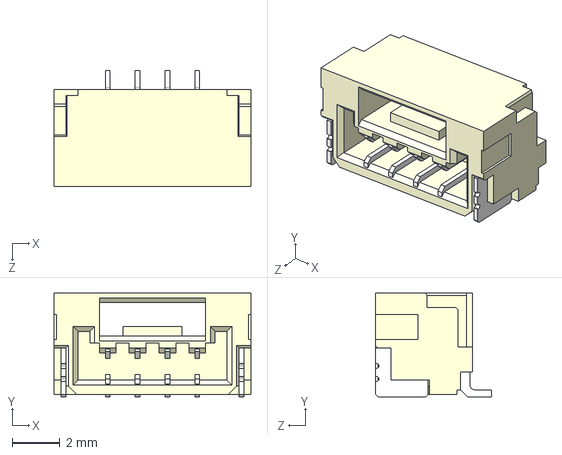
[picture p51: CAD file, 2025-03-24]
KiCad Libraries/SM04B-GHS-TB(LF)(SN)---3DModel-STEP-56544.STEP
8.25 x 4.35 x 4.85 mm
