LZajmi/STM32F4-dev-board/KiCad Libraries/CSTCE8M00G52-R0.STEP

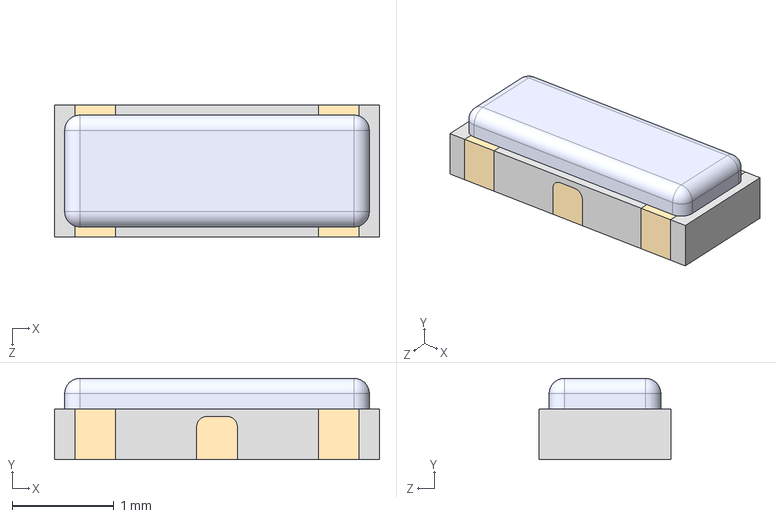
[picture p52: CAD file, 2025-03-24]
KiCad Libraries/CSTCE8M00G52-R0.STEP
3.20 x 0.8 x 1.30 mm
