LZajmi/STM32F4-dev-board/KiCad Libraries/3D model/RP2040--3DModel-STEP-269445.STEP

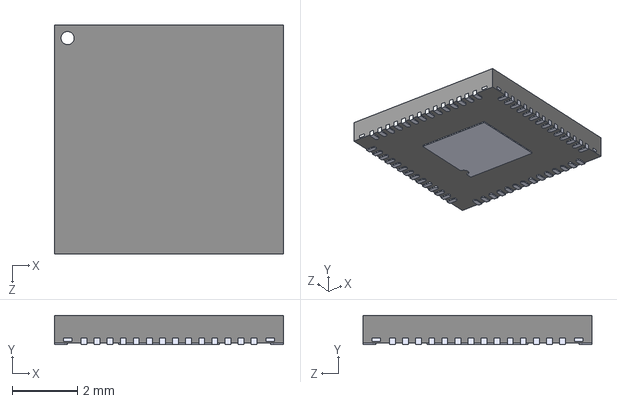
[picture p53: CAD file, 2025-03-24]
KiCad Libraries/3D model/RP2040--3DModel-STEP-269445.STEP
7.00 x 0.9 x 7.00 mm
