LZajmi/STM32F4-dev-board/KiCad Libraries/GRM033R71A103KA01D.STEP

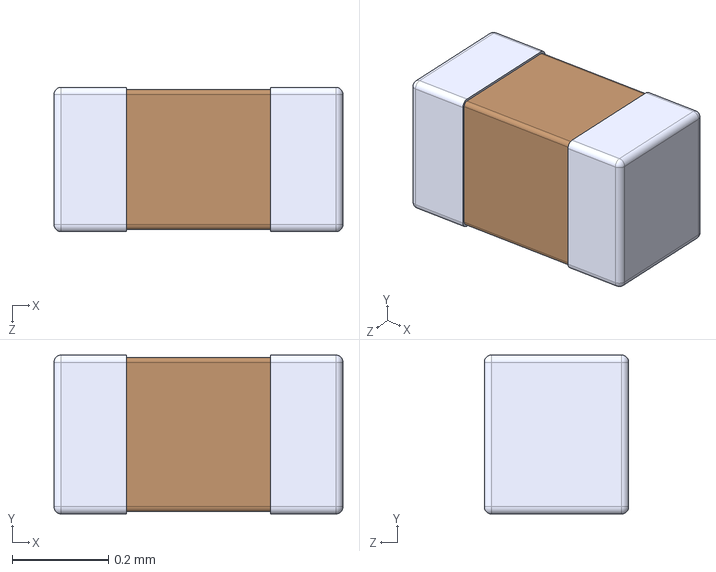
[picture p54: CAD file, 2025-03-24]
KiCad Libraries/GRM033R71A103KA01D.STEP
0.6 x 0.33 x 0.3 mm
