LZajmi/STM32F4-dev-board/KiCad Libraries/3D model/STM32F446RET6--3DModel-STEP-56544.STEP

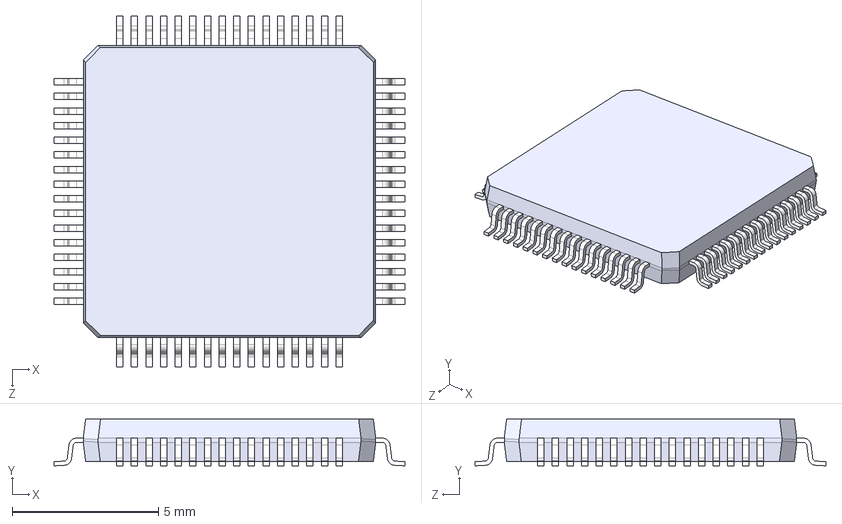
[picture p55: CAD file, 2025-03-24]
KiCad Libraries/3D model/STM32F446RET6--3DModel-STEP-56544.STEP
12.0 x 1.60 x 12.0 mm
