LZajmi/STM32F4-dev-board/KiCad Libraries/SM06B-GHS-TB(LF)(SN)--3DModel-STEP-56544.STEP

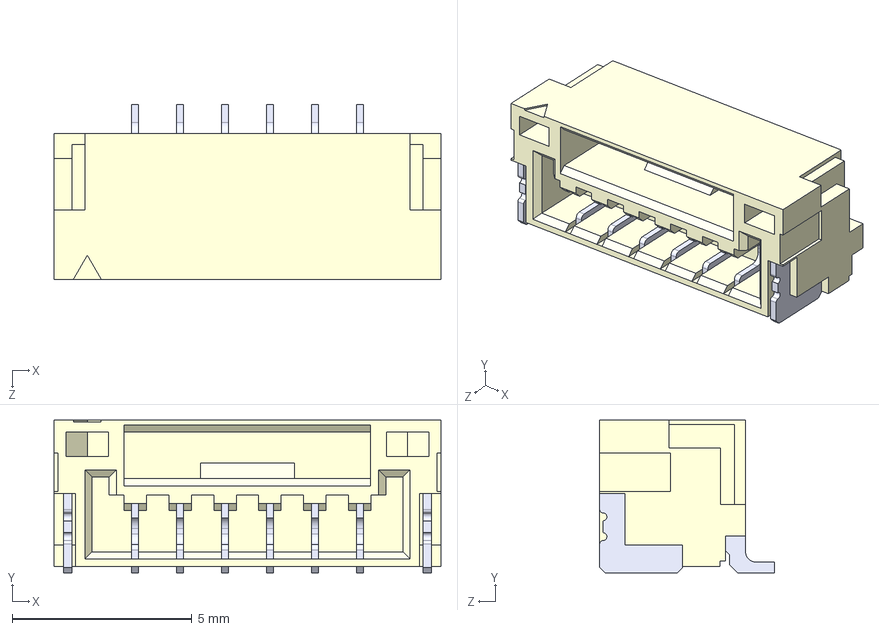
[picture p56: CAD file, 2025-03-24]
KiCad Libraries/SM06B-GHS-TB(LF)(SN)--3DModel-STEP-56544.STEP
10.8 x 4.25 x 4.85 mm
