LZajmi/STM32F4-dev-board/KiCad Libraries/LTST-C190KFKT.STEP

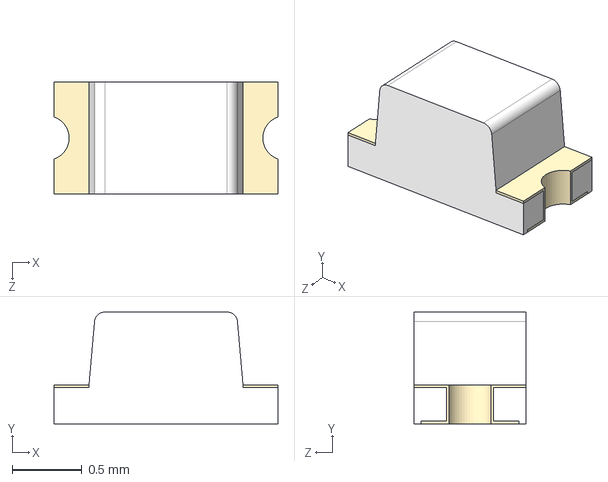
[picture p57: CAD file, 2025-03-24]
KiCad Libraries/LTST-C190KFKT.STEP
1.60 x 0.8 x 0.8 mm
