LZajmi/STM32F4-dev-board/KiCad Libraries/3D model/EFM8SB10F8G-A-QFN20.STEP

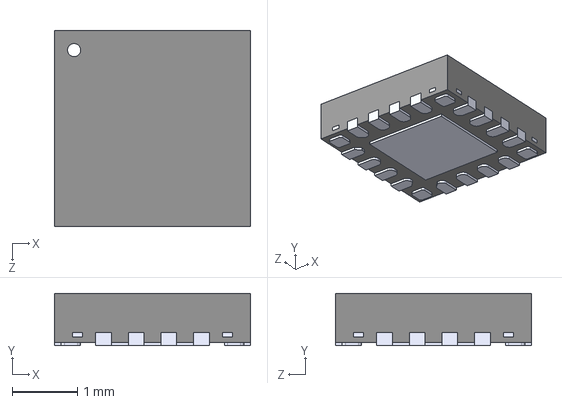
[picture p58: CAD file, 2025-03-24]
KiCad Libraries/3D model/EFM8SB10F8G-A-QFN20.STEP
3.00 x 0.8 x 3.00 mm
