LZajmi/STM32F4-dev-board/KiCad Libraries/3D model/AC0805FR-07360RL.STEP

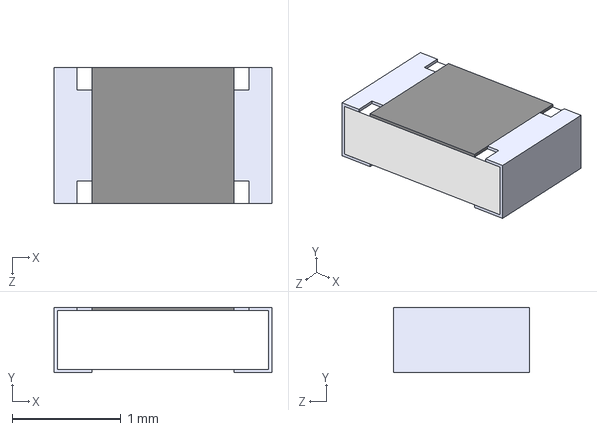
[picture p59: CAD file, 2025-03-24]
KiCad Libraries/3D model/AC0805FR-07360RL.STEP
2.00 x 0.6 x 1.25 mm
