LZajmi/STM32F4-dev-board/KiCad Libraries/3D model/22-27-2021.stp

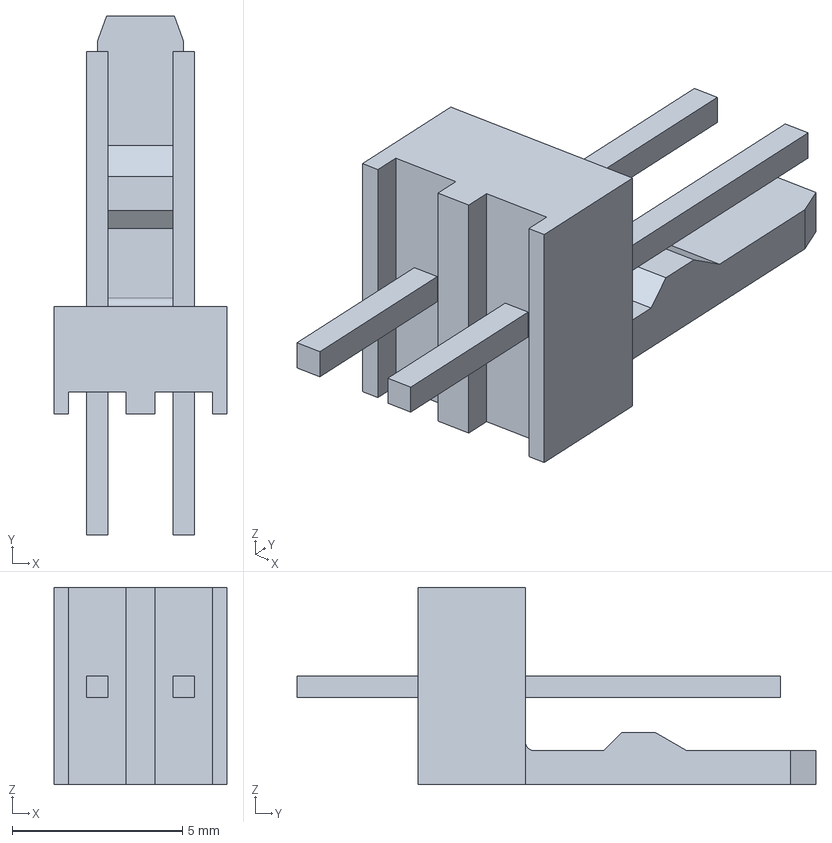
[picture p60: CAD file, 2025-03-24]
KiCad Libraries/3D model/22-27-2021.stp
5.08 x 15.3 x 5.80 mm
