LZajmi/STM32F4-dev-board/KiCad Libraries/3D model/LED.step

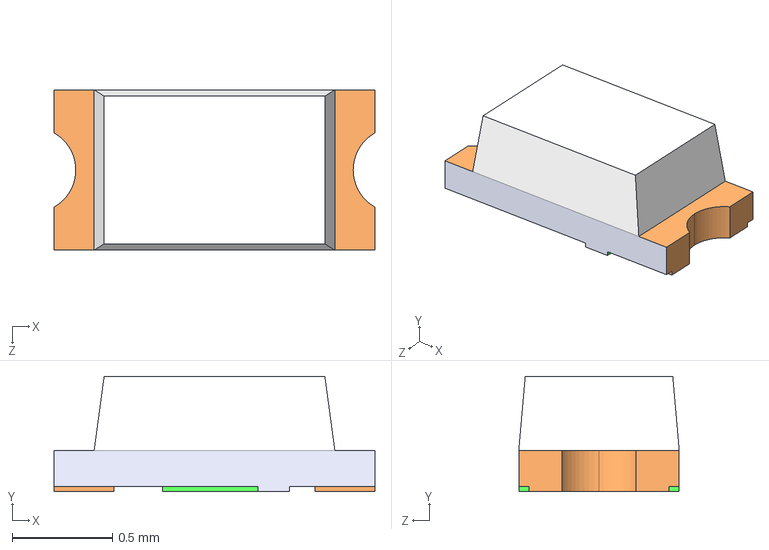
[picture p61: CAD file, 2025-03-24]
KiCad Libraries/3D model/LED.step
1.60 x 0.575 x 0.8 mm
