LZajmi/STM32F4-dev-board/KiCad Libraries/3D model/USB-A1VSB6.step

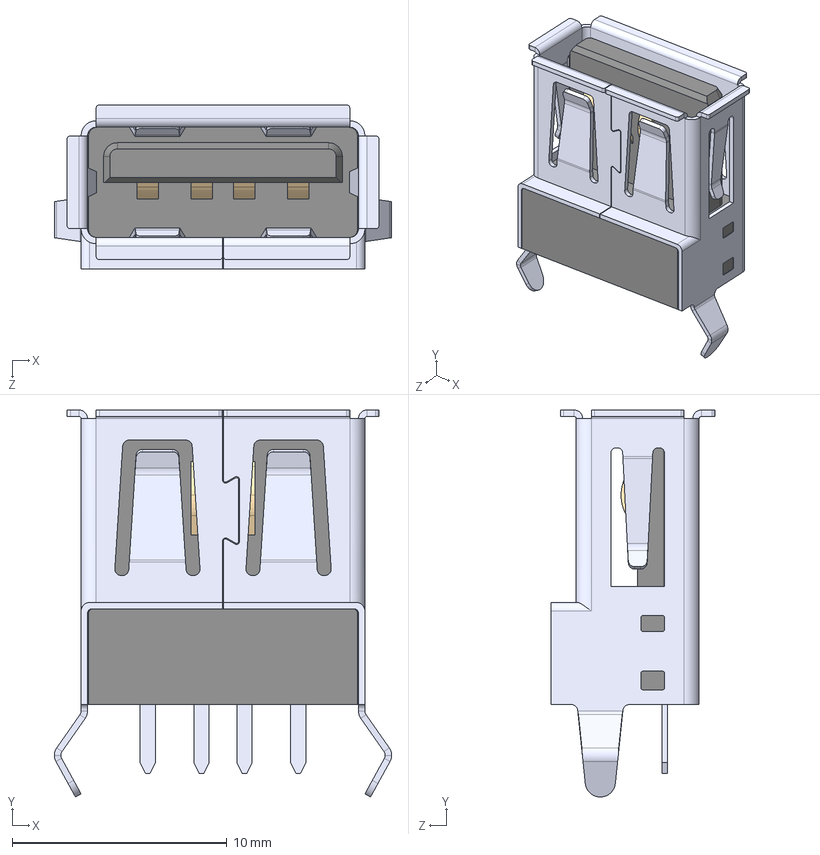
[picture p62: CAD file, 2025-03-24]
KiCad Libraries/3D model/USB-A1VSB6.step
15.7 x 18.0 x 7.64 mm
