LZajmi/STM32F4-dev-board/KiCad Libraries/DX07S016JA1R1500--3DModel-STEP-1.STEP

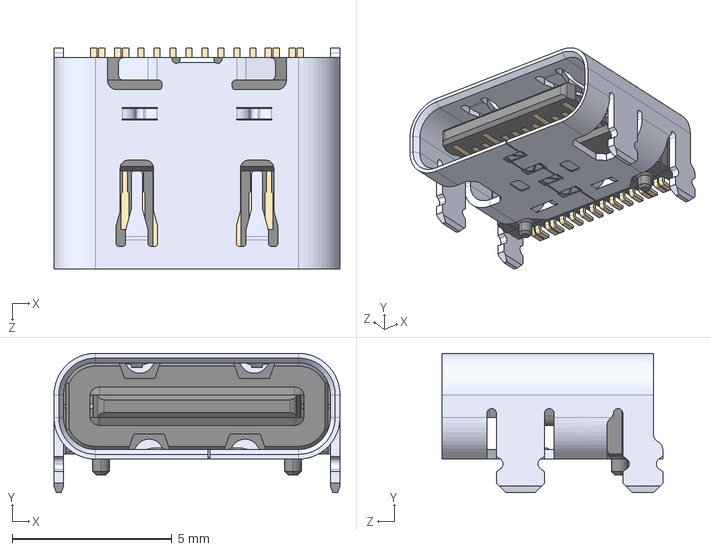
[picture p63: CAD file, 2025-03-24]
KiCad Libraries/DX07S016JA1R1500--3DModel-STEP-1.STEP
8.94 x 4.36 x 6.90 mm
