LZajmi/STM32F4-dev-board/KiCad Libraries/SM08B-GHS-TB-LF--SN---3DModel-STEP-56544.STEP

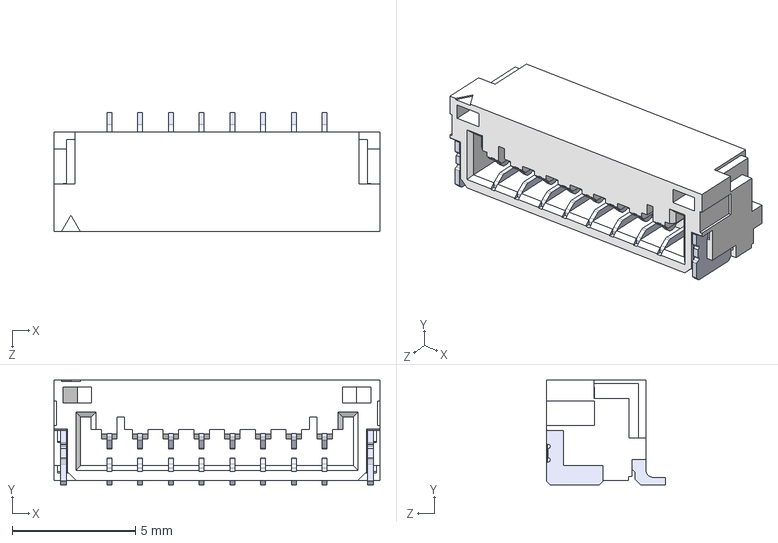
[picture p64: CAD file, 2025-03-24]
KiCad Libraries/SM08B-GHS-TB-LF--SN---3DModel-STEP-56544.STEP
13.2 x 4.25 x 4.85 mm
SMxB-GHS-TB 8plus_8
pin x 8
