LZajmi/STM32F4-dev-board/KiCad Libraries/SPX3819M5-L-3-3_TR.STEP

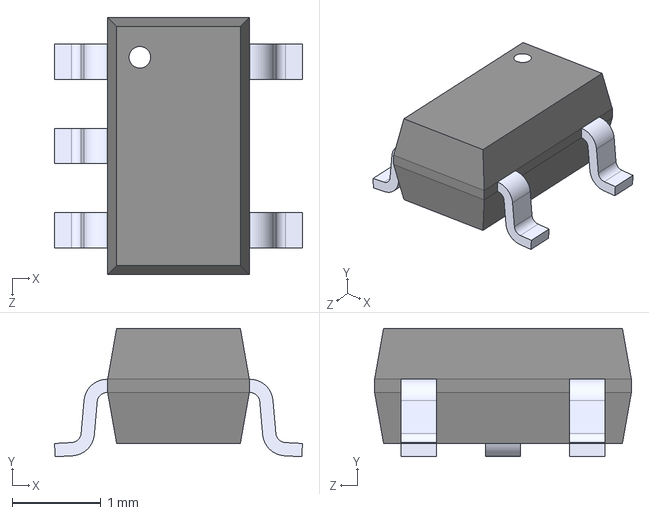
[picture p65: CAD file, 2025-03-24]
KiCad Libraries/SPX3819M5-L-3-3_TR.STEP
2.80 x 1.45 x 2.90 mm
