LZajmi/STM32F4-dev-board/(list of files, cad)

Other CAD files:
KiCad Libraries/ERA2AEB241X/ERA2AEB241X.step
KiCad Libraries/ERJ_2RKF2201X/ERJ2RKF2201X.step
KiCad Libraries/GRM1555C1H180FA01D/GRM1555C1H180FA01D.step
KiCad Libraries/GRM1555C1H220JA01D/GRM1555C1H220JA01D.step
KiCad Libraries/GRM155R60J474KE19D/GRM155R60J474KE19D.step
KiCad Libraries/GRM155R71C103KA01D/GRM155R71C103KA01D.step
KiCad Libraries/RC0402FR-0712KL/RC0402FR-0712KL.step
KiCad Libraries/RC0402FR_074K7L/RC0402FR-074K7L.step
KiCad Libraries/RC0603FR-0749K9L/RC0603FR-0749K9L.step
KiCad Libraries/3D model/GRM1555C1H180FA01D.STEP
KiCad Libraries/RC0603FR-0766K5L.STEP
KiCad Libraries/3D model/GRM1555C1H102JA01D.STEP
KiCad Libraries/STM32F722RET6.STEP
KiCad Libraries/RC0402FR-0712KL.STEP
KiCad Libraries/3D model/GRM1555C1H220JA01D.STEP
KiCad Libraries/ERA-2AEB512X.STEP
KiCad Libraries/RC0603FR-0749K9L.STEP
KiCad Libraries/ERA-2AEB241X.STEP
KiCad Libraries/10029449_111RLF/10029449-111RLF.step
KiCad Libraries/10118193-0001LF--3DModel-STEP-56544.STEP
KiCad Libraries/10118193-0001LF/10118193-0001LF.step
KiCad Libraries/878311020 (1)/878311020.stp
KiCad Libraries/B3AL_1002P (1)/b3al-1002p.stp
KiCad Libraries/CRCW0402220RFKEDC/CRCW0402220RFKEDC/Allegro/resc1005x35n.psm
KiCad Libraries/CRCW0402220RFKEDC/CRCW0402220RFKEDC/DEHDL/crcw0402220rfkedc/chips/chips.prt
KiCad Libraries/ECS-2520MV-130-BN-TR/ECS-2520MV-130-BN-TR/Allegro/ecs2520mv130bntr.psm
KiCad Libraries/ECS-2520MV-130-BN-TR/ECS-2520MV-130-BN-TR/DEHDL/ecs_2520mv_130_bn_tr/chips/chips.prt
KiCad Libraries/LIB_MT25QL512ABB8ESF-0AAT/MT25QL512ABB8ESF-0AAT/Allegro/soic127p1032x265-16n.psm
KiCad Libraries/LIB_MT25QL512ABB8ESF-0AAT/MT25QL512ABB8ESF-0AAT/DEHDL/mt25ql512abb8esf_0aat/chips/chips.prt
KiCad Libraries/LIB_PCM12SMTR/PCM12SMTR/Allegro/pcm12smtr.psm
KiCad Libraries/LIB_PCM12SMTR/PCM12SMTR/DEHDL/pcm12smtr/chips/chips.prt
KiCad Libraries/LIB_RN73R1ETTP50R0F50/RN73R1ETTP50R0F50/Allegro/resc1005x40n.psm
KiCad Libraries/LIB_RN73R1ETTP50R0F50/RN73R1ETTP50R0F50/DEHDL/rn73r1ettp50r0f50/chips/chips.prt
KiCad Libraries/LIB_SN74LV1T125DCKRG4/SN74LV1T125DCKRG4/Allegro/sot65p210x110-5n.psm
KiCad Libraries/LIB_SN74LV1T125DCKRG4/SN74LV1T125DCKRG4/DEHDL/sn74lv1t125dckrg4/chips/chips.prt
KiCad Libraries/LIB_TPD2E009DBZR/TPD2E009DBZR/Allegro/sot95p237x112-3n.psm
KiCad Libraries/LIB_TPD2E009DBZR/TPD2E009DBZR/DEHDL/tpd2e009dbzr/chips/chips.prt
KiCad Libraries/LIB_XFL4015-471MEC/XFL4015-471MEC/Allegro/xfl4012.psm
KiCad Libraries/LIB_XFL4015-471MEC/XFL4015-471MEC/DEHDL/xfl4015_471mec/chips/chips.prt
KiCad Libraries/TPS51200DRCT/TPS51200DRCT.step
KiCad Libraries/usb_b_micro/10118192-0002LF.step
