LZajmi/STM32F4-dev-board/(list of files, drawings)

Other design files:
KiCad Libraries/AltiumDesigner-Libraries-main/Schematic-Lib-PhilsLab.SchLib
KiCad Libraries/AltiumDesigner-Libraries-main/SnapEDApcb.PcbLib
KiCad Libraries/AltiumDesigner-Libraries-main/SnapEDAsch.SchLib
KiCad Libraries/B3AL_1002P/AltiumDesigner/B3AL-1002P.PcbLib
KiCad Libraries/B3AL_1002P/AltiumDesigner/B3AL-1002P.SchLib
KiCad Libraries/B3AL_1003P (1)/AltiumDesigner/B3AL-1003P.PcbLib
KiCad Libraries/B3AL_1003P (1)/AltiumDesigner/B3AL-1003P.SchLib
KiCad Libraries/CAPC1005X55N.PcbLib
KiCad Libraries/CC0201MRX5R6BB105/AltiumDesigner/CC0201MRX5R6BB105.PcbLib
KiCad Libraries/CC0201MRX5R6BB105/AltiumDesigner/CC0201MRX5R6BB105.SchLib
KiCad Libraries/CC0201MRX5R6BB105/AltiumDesigner/Project Outputs for CC0201MRX5R6BB105/CC0201MRX5R6BB105/CC0201MRX5R6BB105.PcbLib
KiCad Libraries/CC0201MRX5R6BB105/AltiumDesigner/Project Outputs for CC0201MRX5R6BB105/CC0201MRX5R6BB105/CC0201MRX5R6BB105.SchLib
KiCad Libraries/CC0402MRX5R6BB106/AltiumDesigner/CC0402MRX5R6BB106.PcbLib
KiCad Libraries/CC0402MRX5R6BB106/AltiumDesigner/CC0402MRX5R6BB106.SchLib
KiCad Libraries/CC0402MRX5R6BB475/CAPC1005X55N.PcbLib
KiCad Libraries/CC0402MRX5R6BB475/CC0402MRX5R6BB475.SchLib
KiCad Libraries/CC0402MRX5R6BB475/CC0402MRX5R6BB475/CAPC1005X55N.PcbLib
KiCad Libraries/CC0402MRX5R6BB475/CC0402MRX5R6BB475/CC0402MRX5R6BB475.SchLib
KiCad Libraries/CRCW0402220RFKEDC/CRCW0402220RFKEDC/Altium/CRCW0402220RFKEDC.SchLib
KiCad Libraries/CRCW0402220RFKEDC/CRCW0402220RFKEDC/Altium/RESC1005X35N.PcbLib
KiCad Libraries/ECS-2520MV-130-BN-TR/ECS-2520MV-130-BN-TR/Altium/ECS2520MV130BNTR.PcbLib
KiCad Libraries/ECS-2520MV-130-BN-TR/ECS-2520MV-130-BN-TR/Altium/ECS-2520MV-130-BN-TR.SchLib
KiCad Libraries/ERA2AEB512X1/ERA2AEB512X.SchLib
KiCad Libraries/ERA2AEB512X1/RES_ERA2AEB512X.PcbLib
KiCad Libraries/ERA2AEB512X (1)/ERA2AEB512X.SchLib
KiCad Libraries/ERA2AEB512X (1)/RES_ERA2AEB512X.PcbLib
KiCad Libraries/ERA2AEB512X/ERA2AEB512X.SchLib
KiCad Libraries/ERA2AEB512X/RES_ERA2AEB512X.PcbLib
KiCad Libraries/GRM033R61A104KE15D/CAPC0603X33N.PcbLib
KiCad Libraries/GRM033R61A104KE15D/GRM033R61A104KE15D.SchLib
KiCad Libraries/GRM033R61A104KE15D/GRM033R61A104KE15D/CAPC0603X33N.PcbLib
KiCad Libraries/GRM033R61A104KE15D/GRM033R61A104KE15D/GRM033R61A104KE15D.SchLib
KiCad Libraries/GRM033R71A103KA01D/CAPC0603X33N.PcbLib
KiCad Libraries/GRM033R71A103KA01D/GRM033R71A103KA01D.SchLib
KiCad Libraries/GRM155C80J225KE95D/CAPC1005X55N.PcbLib
KiCad Libraries/GRM155C80J225KE95D/GRM155C80J225KE95D.SchLib
KiCad Libraries/GRM155C80J225KE95D/GRM155C80J225KE95D/CAPC1005X55N.PcbLib
KiCad Libraries/GRM155C80J225KE95D/GRM155C80J225KE95D/GRM155C80J225KE95D.SchLib
KiCad Libraries/GRM155R70J222KA01D/CAPC1005X55N.PcbLib
KiCad Libraries/GRM155R70J222KA01D/GRM155R70J222KA01D.SchLib
KiCad Libraries/GRM155R70J222KA01D/GRM155R70J222KA01D/CAPC1005X55N.PcbLib
KiCad Libraries/GRM155R70J222KA01D/GRM155R70J222KA01D/GRM155R70J222KA01D.SchLib
KiCad Libraries/LIB_PCM12SMTR/PCM12SMTR/Altium/PCM12SMTR.PcbLib
KiCad Libraries/LIB_PCM12SMTR/PCM12SMTR/Altium/PCM12SMTR.SchLib
KiCad Libraries/LIB_RN73R1ETTP50R0F50/RN73R1ETTP50R0F50/Altium/RESC1005X40N.PcbLib
KiCad Libraries/LIB_RN73R1ETTP50R0F50/RN73R1ETTP50R0F50/Altium/RN73R1ETTP50R0F50.SchLib
KiCad Libraries/LIB_SN74LV1T125DCKRG4/SN74LV1T125DCKRG4/Altium/SN74LV1T125DCKRG4.SchLib
KiCad Libraries/LIB_SN74LV1T125DCKRG4/SN74LV1T125DCKRG4/Altium/SOT65P210X110-5N.PcbLib
KiCad Libraries/LTST-C190KFKT/LEDM1608X80.PcbLib
KiCad Libraries/LTST-C190KFKT/LTST-C190KFKT.SchLib
KiCad Libraries/RC0603FR_075K1L/RC0603FR-075K1L1/RC0603FR-075K1L.SchLib
KiCad Libraries/RC0603FR_075K1L/RC0603FR-075K1L1/RESC1607X60N.PcbLib
KiCad Libraries/RC0603FR_075K1L/RC0603FR-075K1L/RC0603FR-075K1L.SchLib
KiCad Libraries/RC0603FR_075K1L/RC0603FR-075K1L/RESC1607X60N.PcbLib
KiCad Libraries/SMD-RES-1K-5_-1_16W_0402_/R0402.PcbLib
KiCad Libraries/SMD-RES-1K-5_-1_16W_0402_/SMD-RES-1K-5%-1_16W(0402).SchLib
KiCad Libraries/SP3003_02XTG/AltiumDesigner/SP3003-02XTG.PcbLib
KiCad Libraries/SP3003_02XTG/AltiumDesigner/SP3003-02XTG.SchLib
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
