LZajmi/STM32F4-dev-board/STM32 Development Board.kicad_pcb

## KiCad design STM32 Development Board.kicad_pcb (2025-01-15)

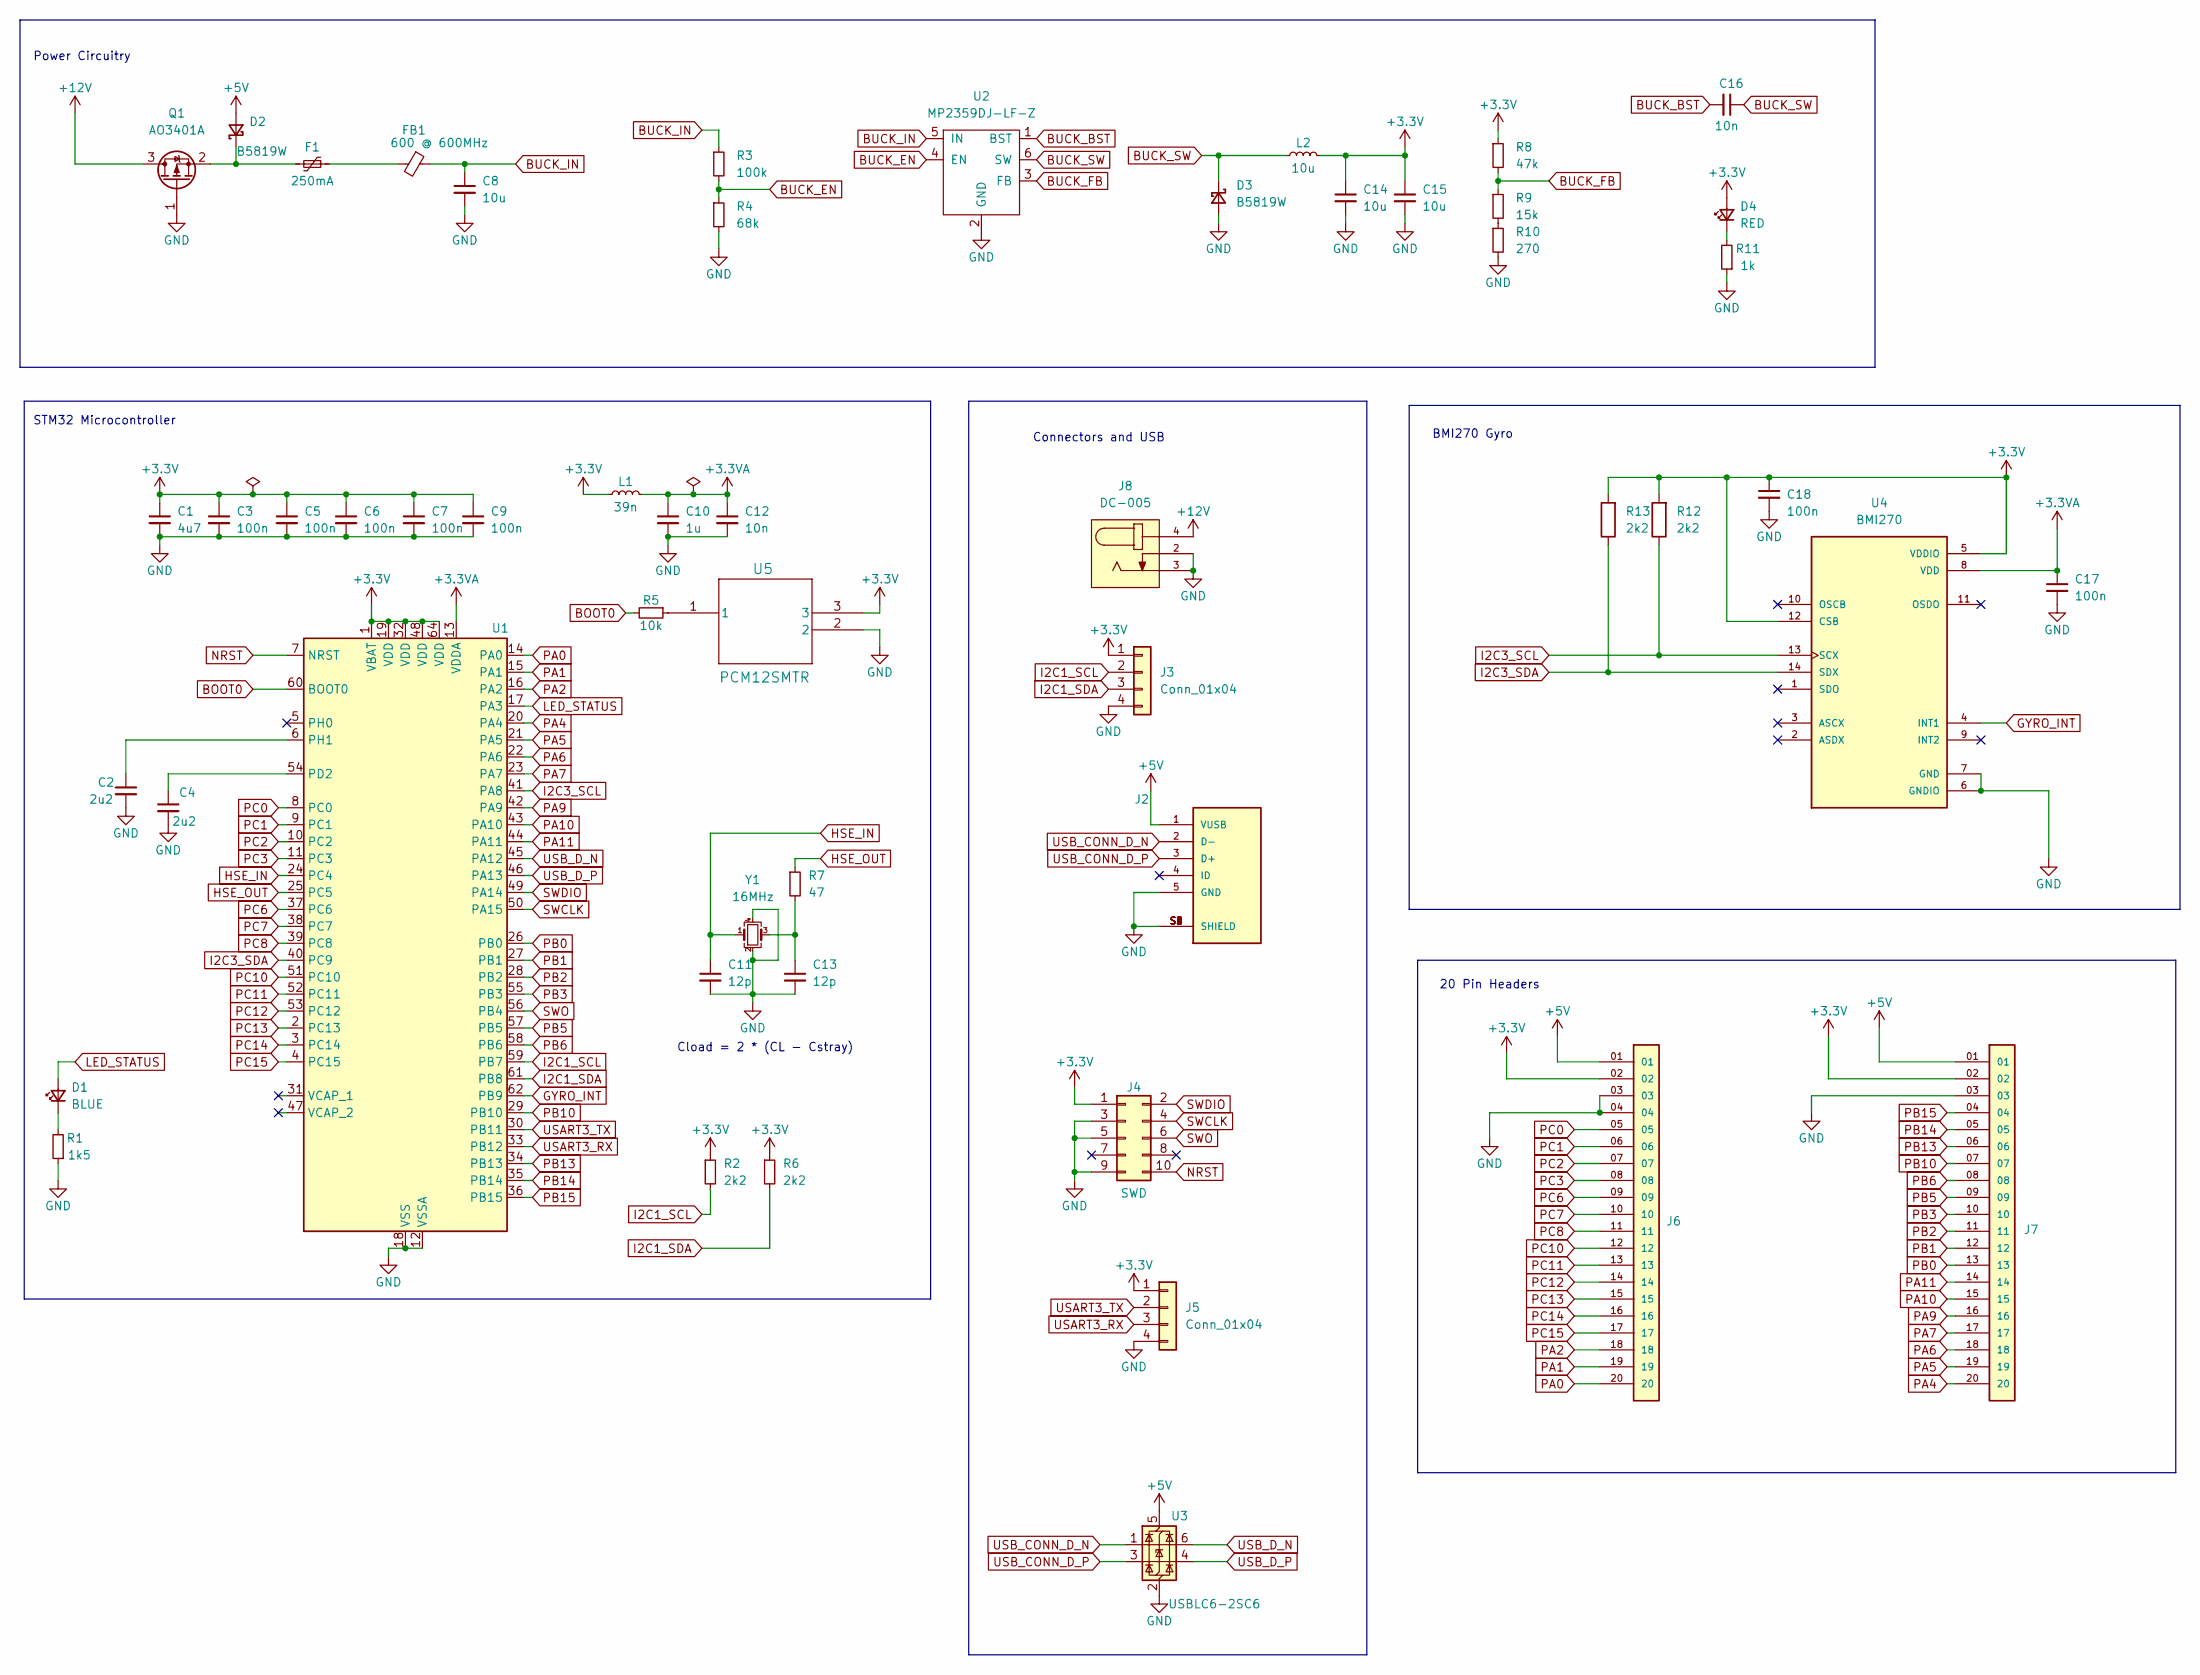
[picture p66: schematic STM32 Development Board.kicad_sch]

Parts:
C1: 4u7; C_0603_1608Metric; LCSC Part # C19666
C2, C4: 2u2; C_0603_1608Metric; LCSC Part # C23630
C3, C5, C6, C7, C9, C17, C18: 100n; C_0402_1005Metric; LCSC Part # C1525
C8, C14, C15: 10u; C_1206_3216Metric; LCSC Part # C13585
C10: 1u; C_0402_1005Metric; LCSC Part # C52923
C11, C13: 12p; C_0402_1005Metric; LCSC Part # C1547
C12: 10n; C_0402_1005Metric; LCSC Part # C15195
C16: 10n; C_0603_1608Metric; LCSC Part # C57112
D1: BLUE; LED_0603_1608Metric; LCSC Part # C72041
D2, D3: B5819W; D_SOD-123; LCSC Part # C8598
D4: RED; LED_0603_1608Metric; LCSC Part # C2286
F1: 250mA; Fuse_1206_3216Metric; LCSC Part # C369159
FB1: 600 @ 600MHz; L_0805_2012Metric; LCSC Part # C1017
J2: 10118193-0001LF; AMPHENOL_10118193-0001LF; PARTREV E
J3, J5: Conn_01x04; Molex_PicoBlade_53048-0410_1x04_P1.25mm_Horizontal
J4: SWD; PinHeader_2x05_P1.27mm_Vertical_SMD
J6, J7: TSW-120-24-T-S; SAMTEC_TSW-120-24-T-S; PARTREV R
J8: DC-005; NINIGI_DC-005
L1: 39n; L_0402_1005Metric; LCSC Part # C26443
L2: 10u; IND_SPM6530T-100M-HZ; LCSC Part # C360728
Q1: AO3401A; SOT-23; LCSC Part # C15127
R1: 1k5; R_0603_1608Metric; LCSC Part # C22843
R2, R6: 2k2; R_0402_1005Metric; LCSC Part # C25879
R3: 100k; R_0603_1608Metric; LCSC Part # C25803
R4: 68k; R_0603_1608Metric; LCSC Part # C23231
R5: 10k; R_0402_1005Metric; LCSC Part # C25744
R7: 47; R_0402_1005Metric; LCSC Part # C25118
R8: 47k; R_0603_1608Metric; LCSC Part # C25819
R9: 15k; R_0603_1608Metric; LCSC Part # C22809
R10: 270; R_0603_1608Metric; LCSC Part # C22966
R11: 1k; R_0603_1608Metric; LCSC Part # C21190
R12, R13: 2k2; R_0402_1005Metric
U1: STM32F405RGT6; LQFP-64_10x10mm_P0.5mm; LCSC Part # C15742
U2: MP2359DJ-LF-Z; SOT-23-6; LCSC Part # C14259
U3: USBLC6-2SC6; SOT-23-6; LCSC Part # C7519
U4: BMI270; XDCR_BMI270
U5: PCM12SMTR
Y1: 16MHz; Crystal_SMD_3225-4Pin_3.2x2.5mm; LCSC Part # C13738

Connections:
+3.3VA: C10.1, C12.1, C17.1, L1.2, U1.13 (VDDA), U4.8 (VDD)
+12V: J8.4, Q1.3 (D)
BOOT0: R5.2, U1.60 (BOOT0)
BUCK_BST: C16.2, U2.1 (BST)
BUCK_EN: R3.2, R4.1, U2.4 (EN)
BUCK_FB: R8.2, R9.1, U2.3 (FB)
BUCK_IN: C8.1, FB1.1, R3.1, U2.5 (IN)
BUCK_SW: C16.1, D3.1 (K), L2.1, U2.6 (SW)
GND: C1.2, C2.2, C3.2, C4.2, C5.2, C6.2, C7.2, C8.2, C9.2, C10.2, C11.2, C12.2, C13.2, C14.2, C15.2, C17.2, C18.2, D3.2 (A), J2.5 (GND), J2.S1 (SHIELD), J2.S2 (SHIELD), J2.S3 (SHIELD), J2.S4 (SHIELD), J2.S5 (SHIELD), J2.S6 (SHIELD), J3.4, J4.3, J4.5, J4.9, J5.4, J6.03, J6.04, J7.03, J8.2, J8.3, Q1.1 (G), R1.1, R4.2, R10.2, R11.1, U1.12 (VSSA), U1.18 (VSS), U1.63 (VSS), U2.2 (GND), U3.2 (GND), U4.6 (GNDIO), U4.7 (GND), U5.2, Y1.2, Y1.4; also elsewhere on the board
GYRO_INT: U1.62 (PB9), U4.4 (INT1)
HSE_IN: C11.1, U1.24 (PC4), Y1.1
HSE_OUT: R7.1, U1.25 (PC5)
I2C1_SCL: J3.2, R2.2, U1.59 (PB7)
I2C1_SDA: J3.3, R6.2, U1.61 (PB8)
I2C3_SCL: R12.1, U1.41 (PA8), U4.13 (SCX)
I2C3_SDA: R13.1, U1.40 (PC9), U4.14 (SDX)
LED_STATUS: D1.2 (A), U1.17 (PA3)
NRST: J4.10, U1.7 (NRST)
unnamed: C13.1, R7.2, Y1.3
unnamed: D1.1 (K), R1.2
unnamed: D2.1 (K), F1.2, Q1.2 (S)
unnamed: D4.1 (K), R11.2
unnamed: F1.1, FB1.2
unnamed: R9.2, R10.1
unnamed 24: R5.1, U5.1; also elsewhere on the board
unnamed: C4.1, U1.54 (PD2)
unnamed: C2.1, U1.6 (PH1)
PA0: J6.20, U1.14 (PA0)
PA1: J6.19, U1.15 (PA1)
PA2: J6.18, U1.16 (PA2)
PA4: J7.20, U1.20 (PA4)
PA5: J7.19, U1.21 (PA5)
PA6: J7.18, U1.22 (PA6)
PA7: J7.17, U1.23 (PA7)
PA9: J7.16, U1.42 (PA9)
PA10: J7.15, U1.43 (PA10)
PA11: J7.14, U1.44 (PA11)
PB0: J7.13, U1.26 (PB0)
PB1: J7.12, U1.27 (PB1)
PB2: J7.11, U1.28 (PB2)
PB3: J7.10, U1.55 (PB3)
PB5: J7.09, U1.57 (PB5)
PB6: J7.08, U1.58 (PB6)
PB10: J7.07, U1.29 (PB10)
PB13: J7.06, U1.34 (PB13)
PB14: J7.05, U1.35 (PB14)
PB15: J7.04, U1.36 (PB15)
PC0: J6.05, U1.8 (PC0)
PC1: J6.06, U1.9 (PC1)
PC2: J6.07, U1.10 (PC2)
PC3: J6.08, U1.11 (PC3)
PC6: J6.09, U1.37 (PC6)
PC7: J6.10, U1.38 (PC7)
PC8: J6.11, U1.39 (PC8)
PC10: J6.12, U1.51 (PC10)
PC11: J6.13, U1.52 (PC11)
PC12: J6.14, U1.53 (PC12)
PC13: J6.15, U1.2 (PC13)
PC14: J6.16, U1.3 (PC14)
PC15: J6.17, U1.4 (PC15)
SWCLK: J4.4, U1.50 (PA15)
SWDIO: J4.2, U1.49 (PA14)
SWO: J4.6, U1.56 (PB4)
USART3_RX: J5.3, U1.33 (PB12)
USART3_TX: J5.2, U1.30 (PB11)
USB_CONN_D_N: J2.2 (D-), U3.1 (I/O1)
USB_CONN_D_P: J2.3 (D+), U3.3 (I/O2)
USB_D_N: U1.45 (PA12), U3.6 (I/O1)
USB_D_P: U1.46 (PA13), U3.4 (I/O2)

Notes on the sheet:
Cload = 2 * (CL - Cstray)
20 Pin Headers
BMI270 Gyro
STM32 Microcontroller
Connectors and USB
Power Circuitry

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
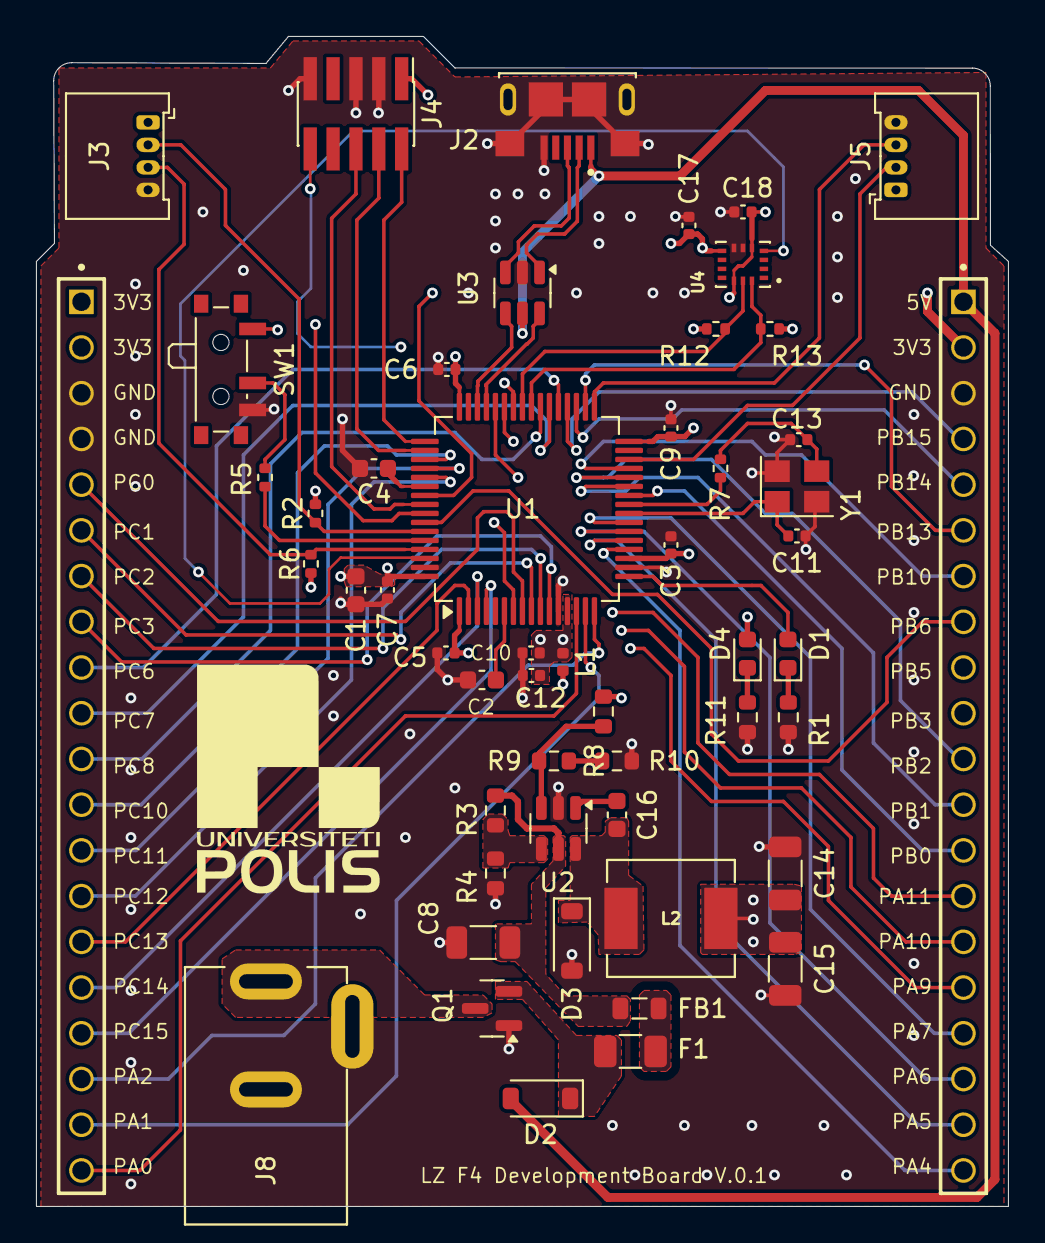
[picture p67: board STM32 Development Board.kicad_pcb from above]

Board: 4 copper layers, 54.0 x 65.0 mm, 53 parts (0 on the bottom side), 71 nets.

Other parts of the board:
SW1: SW_SPDT; SW_SPDT_PCM12

Their connections:
GND: SW1.3 (C); also elsewhere on the board
unnamed 24: SW1.2 (B); also elsewhere on the board
