LZajmi/STM32F4-dev-board/(notices)

Notices in the files:
KiCad Libraries/FW-10-04-G-D-100-065/FW-10-04-G-D-100-065.step:
author */ ('License CC BY-ND 4.0'),
